IN-AIR-KR/26_HC056/images/readme/launch_video_thumb.jpg

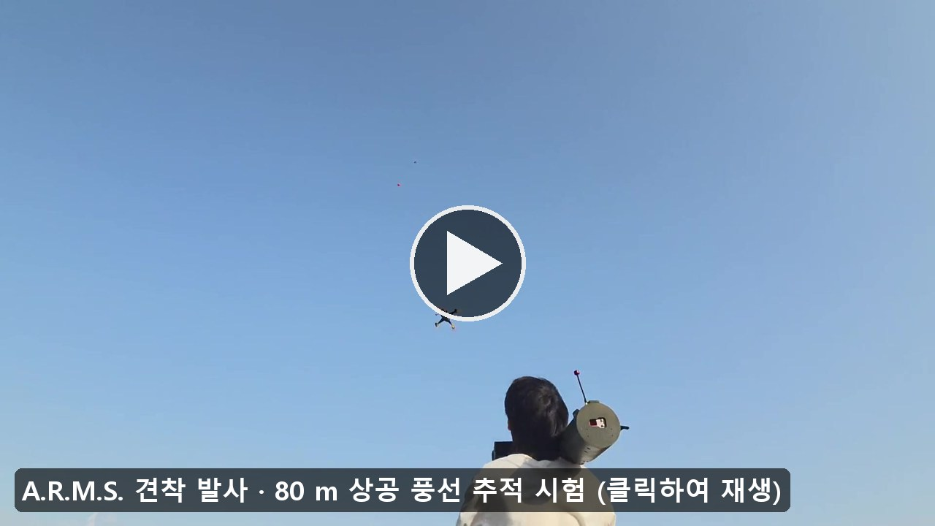
images/readme/launch_video_thumb.jpg
