IN-AIR-KR/26_HC056/SW/arms_ws/src/arms_sim/assets/models/arms_drone/meshes/ver_ksh_assembly.stl

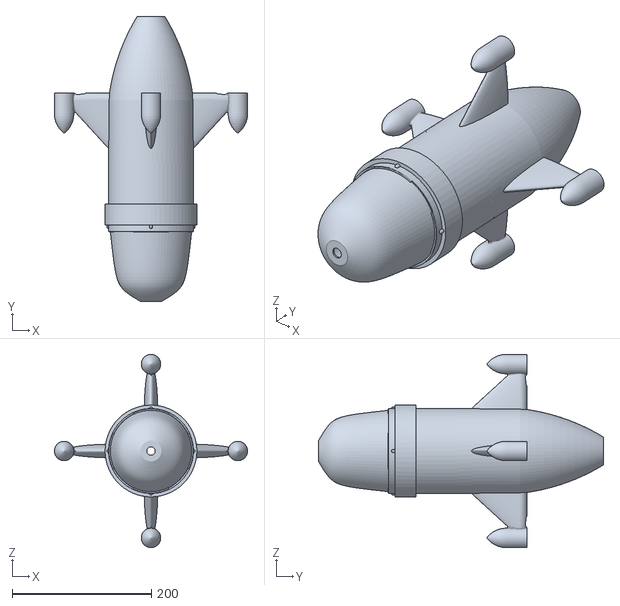
[picture p16: CAD file, 2026-06-16]
SW/arms_ws/src/arms_sim/assets/models/arms_drone/meshes/ver_ksh_assembly.stl
278.0 x 410.0 x 278.0
