IN-AIR-KR/26_HC056/HW/drone_step/electronics_mount_3.step

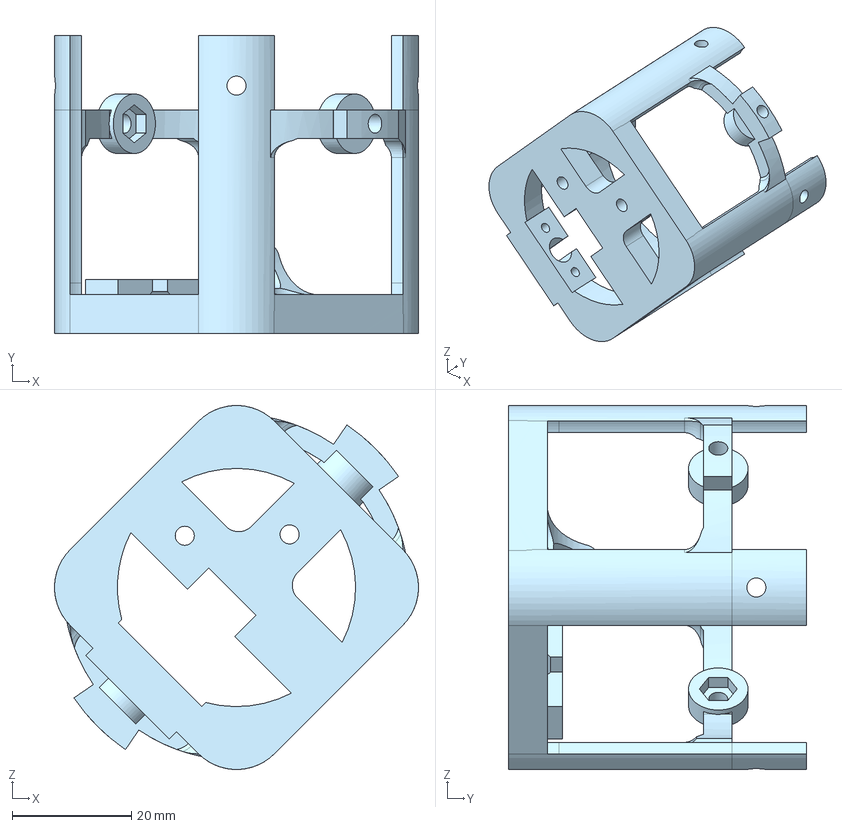
[picture p17: CAD file, 2026-10-19]
HW/drone_step/electronics_mount_3.step
61.1 x 50.0 x 61.1 mm
