IN-AIR-KR/26_HC056/HW/launcher_step/control_panel.step

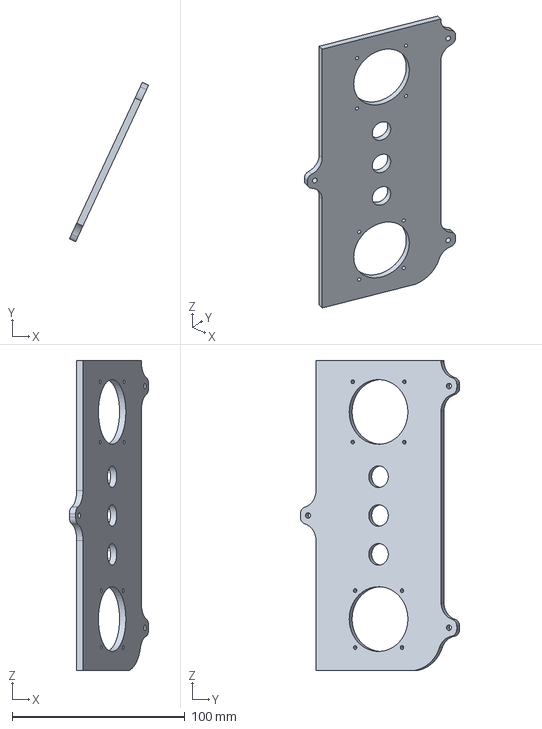
[picture p18: CAD file, 2026-10-19]
HW/launcher_step/control_panel.step
45.9 x 92.3 x 179.6 mm
