IN-AIR-KR/26_HC056/SW/arms_ws/src/arms_sim/assets/models/arms_drone/meshes/arms_model_v2.stl

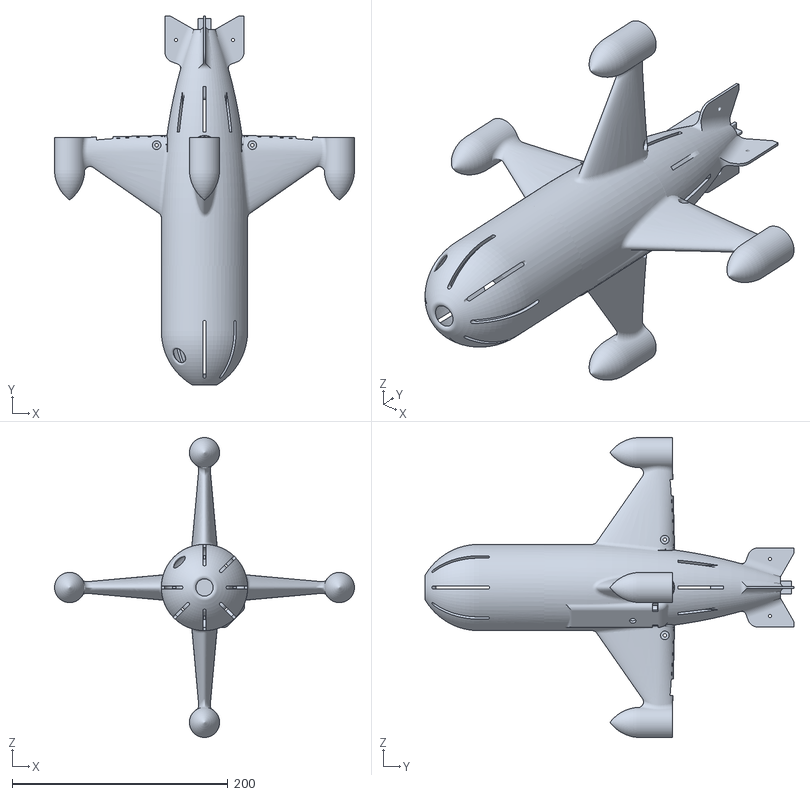
[picture p19: CAD file, 2026-08-10]
SW/arms_ws/src/arms_sim/assets/models/arms_drone/meshes/arms_model_v2.stl
278.0 x 341.9 x 278.0
