IN-AIR-KR/26_HC056/HW/drone_step/electronics_mount_1.step

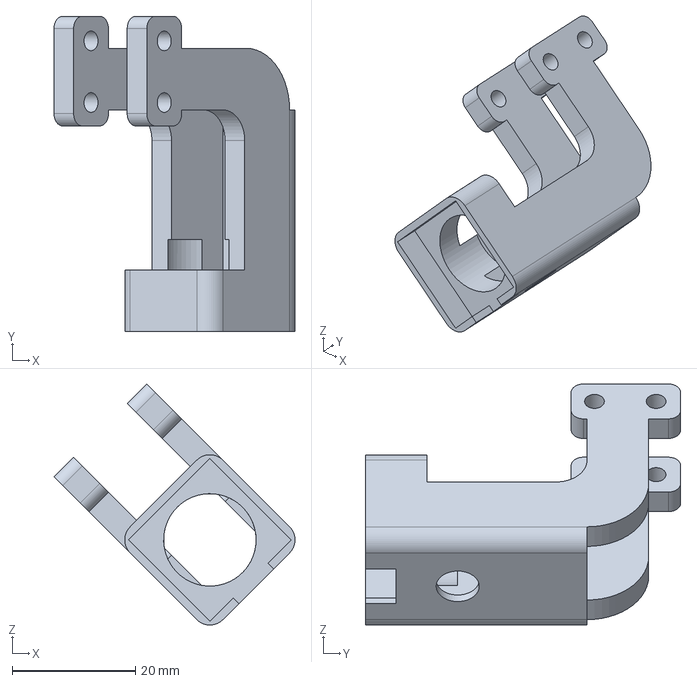
[picture p20: CAD file, 2026-10-19]
HW/drone_step/electronics_mount_1.step
39.1 x 51.2 x 39.1 mm
