IN-AIR-KR/26_HC056/HW/launcher_step/head.step

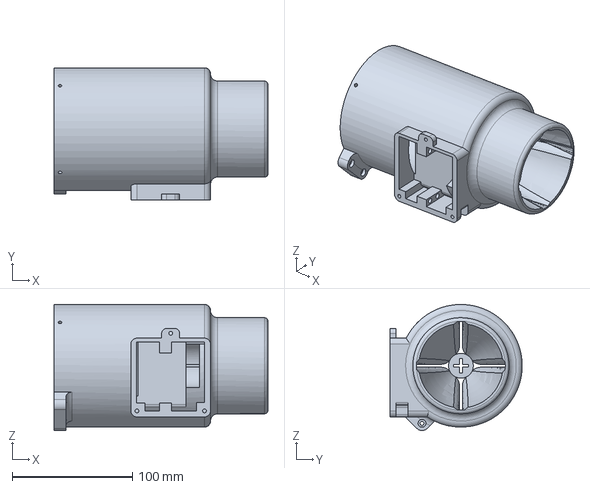
[picture p21: CAD file, 2026-10-19]
HW/launcher_step/head.step
178.0 x 110.1 x 104.9 mm
