IN-AIR-KR/26_HC056/SW/arms_ws/src/arms_sim/assets/models/arms_drone/meshes/1345_prop_cw.stl

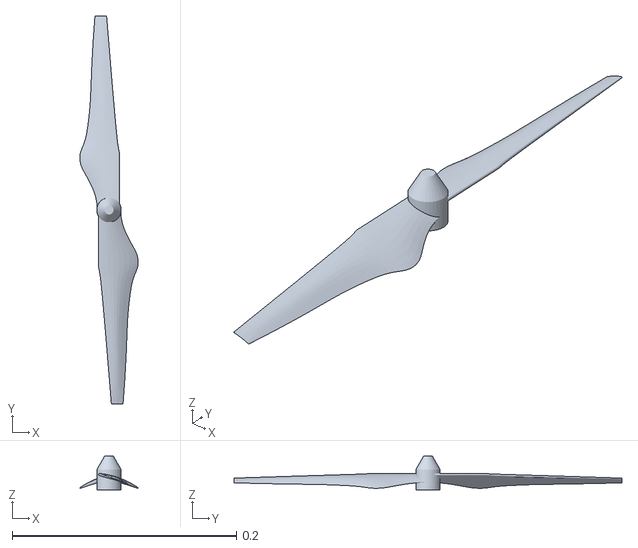
[picture p22: CAD file, 2026-06-16]
SW/arms_ws/src/arms_sim/assets/models/arms_drone/meshes/1345_prop_cw.stl
0.052 x 0.346 x 0.03
