IN-AIR-KR/26_HC056/HW/drone_step/body_1.step

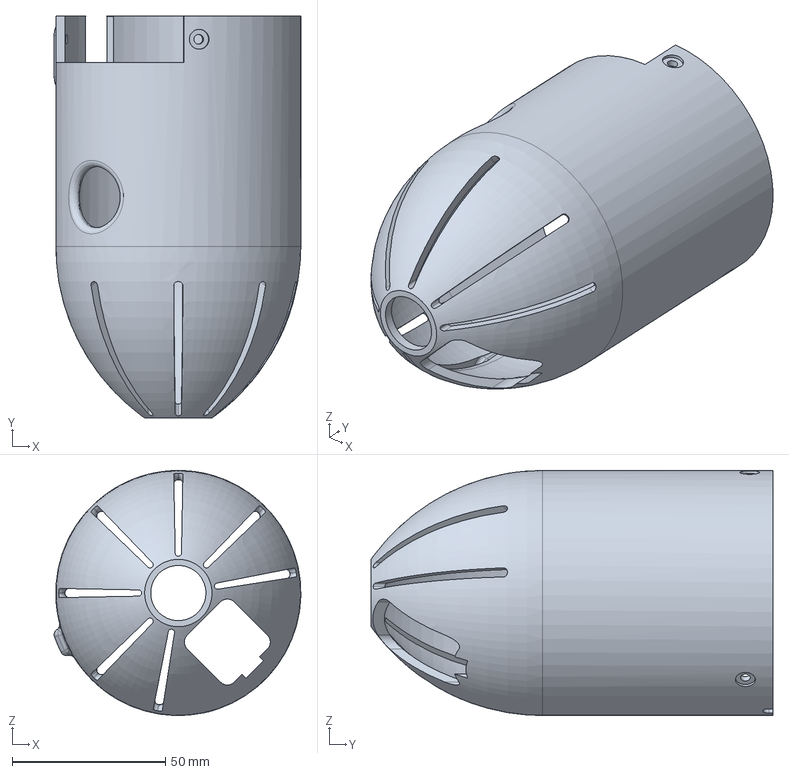
[picture p23: CAD file, 2026-10-19]
HW/drone_step/body_1.step
80.5 x 131.2 x 80.0 mm
