IN-AIR-KR/26_HC056/HW/launcher_step/servo_cover.step

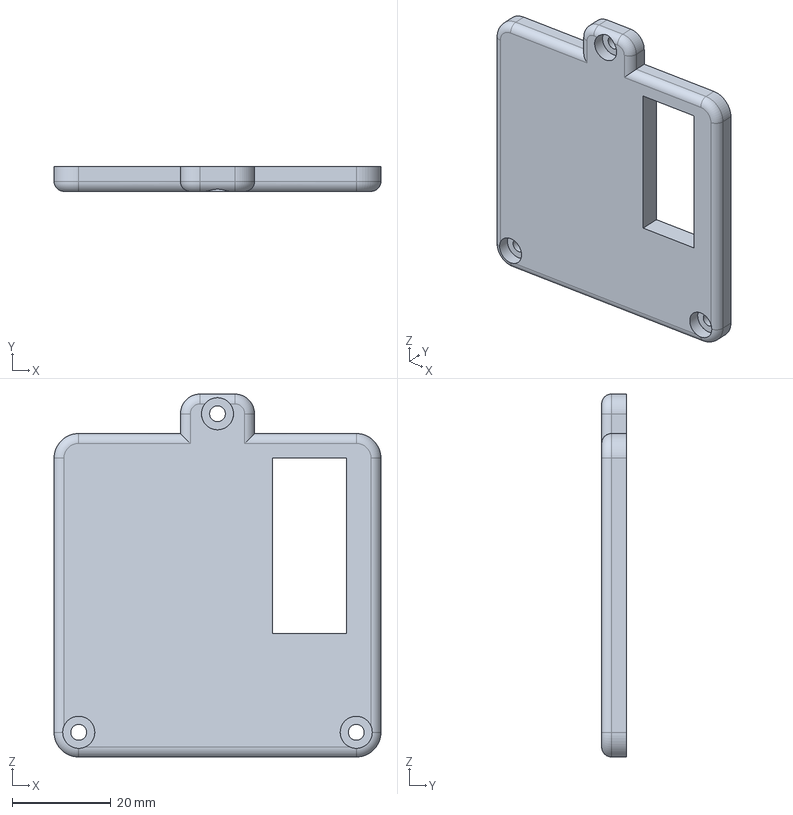
[picture p24: CAD file, 2026-10-19]
HW/launcher_step/servo_cover.step
66.2 x 5.00 x 73.5 mm
