IN-AIR-KR/26_HC056/HW/drone_step/electronics_mount_4.step

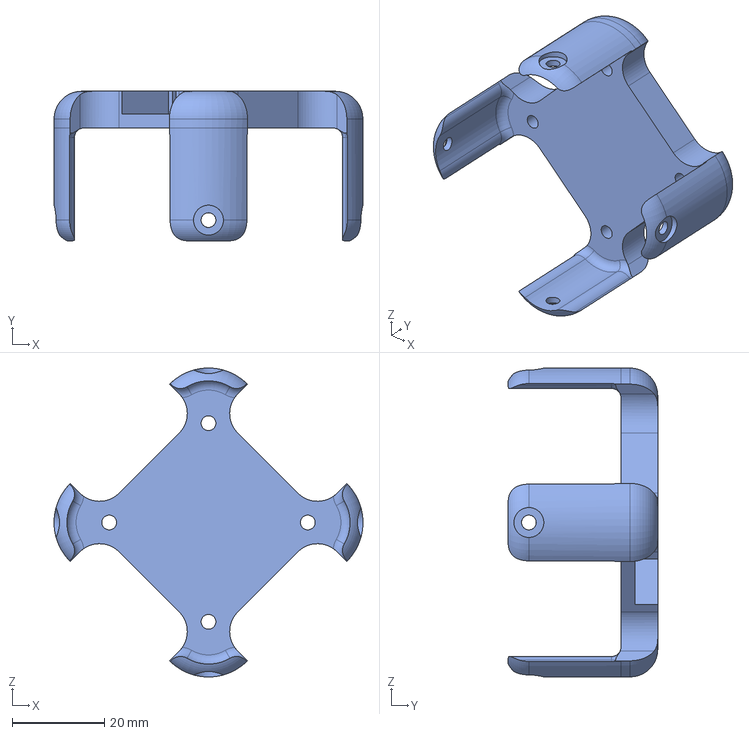
[picture p25: CAD file, 2026-10-19]
HW/drone_step/electronics_mount_4.step
67.1 x 32.5 x 67.1 mm
