IN-AIR-KR/26_HC056/HW/launcher_step/body.step

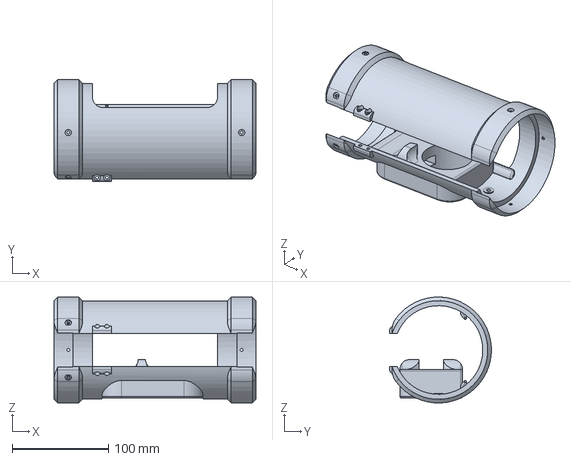
[picture p26: CAD file, 2026-10-19]
HW/launcher_step/body.step
209.6 x 105.7 x 110.0 mm
