IN-AIR-KR/26_HC056/HW/drone_step/body_2.step

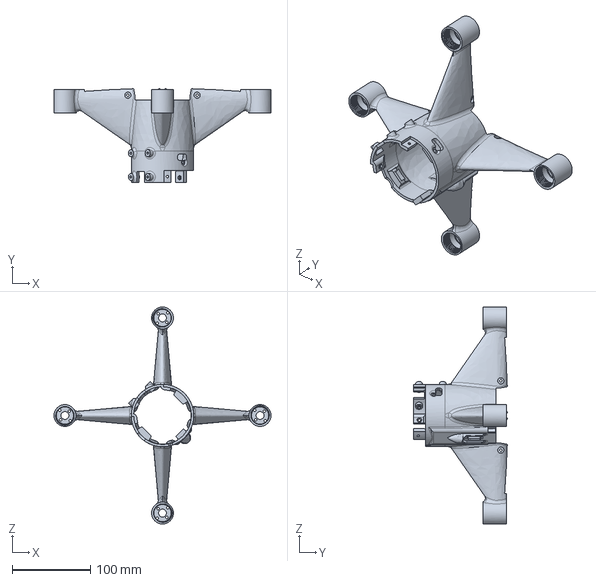
[picture p27: CAD file, 2026-10-19]
HW/drone_step/body_2.step
278.0 x 120.6 x 278.0 mm
