IN-AIR-KR/26_HC056/HW/launcher_step/second_body.step

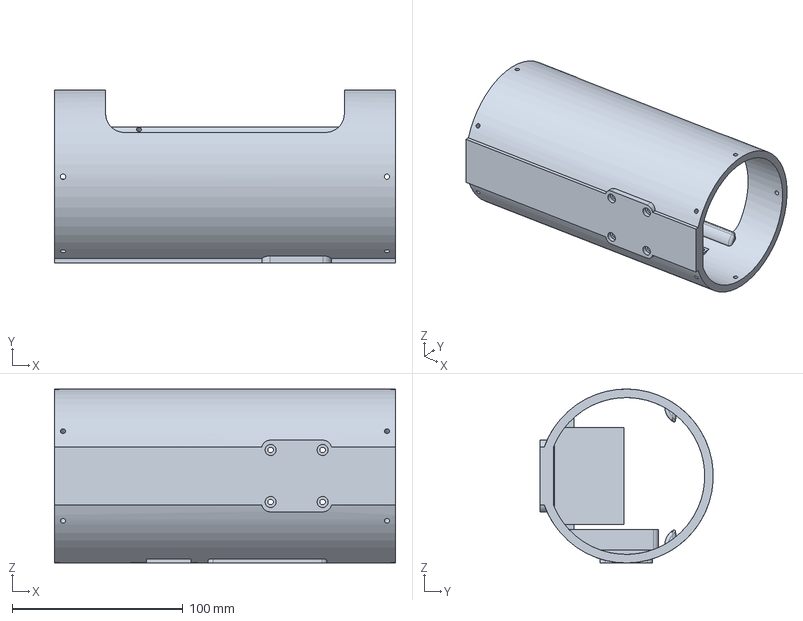
[picture p28: CAD file, 2026-10-19]
HW/launcher_step/second_body.step
200.0 x 101.7 x 102.0 mm
