IN-AIR-KR/26_HC056/HW/drone_step/electronics_mount_2.step

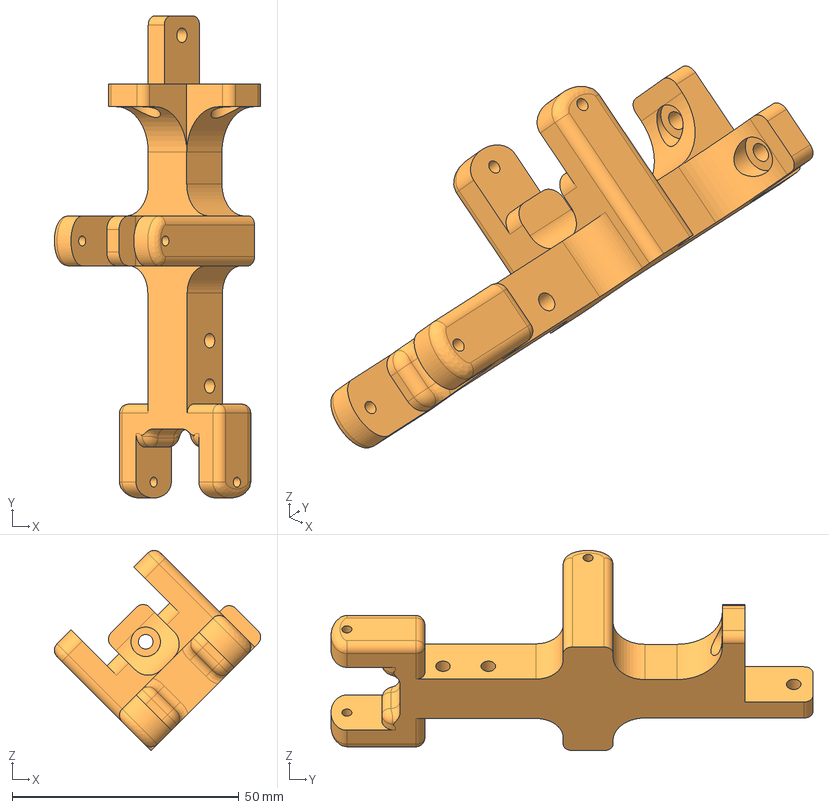
[picture p29: CAD file, 2026-10-19]
HW/drone_step/electronics_mount_2.step
45.5 x 106.3 x 44.1 mm
