IN-AIR-KR/26_HC056/HW/launcher_step/trigger.step

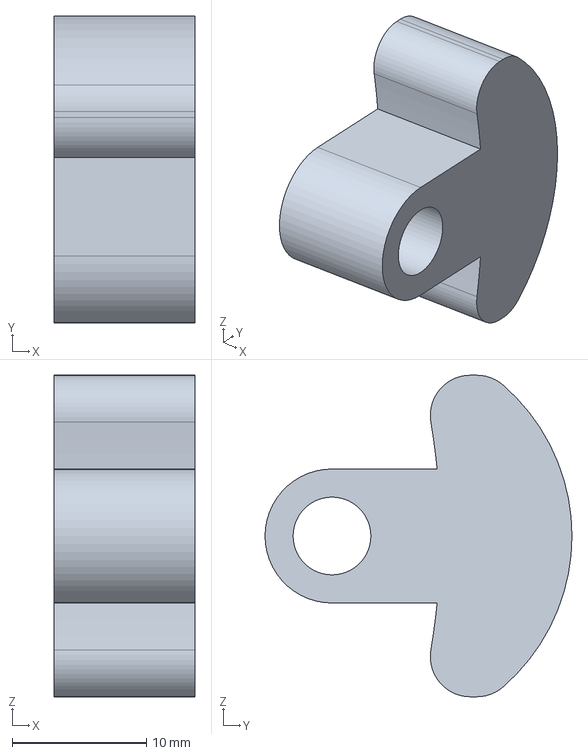
[picture p30: CAD file, 2026-10-19]
HW/launcher_step/trigger.step
10.5 x 22.9 x 24.0 mm
