IN-AIR-KR/26_HC056/HW/drone_step/body_3.step

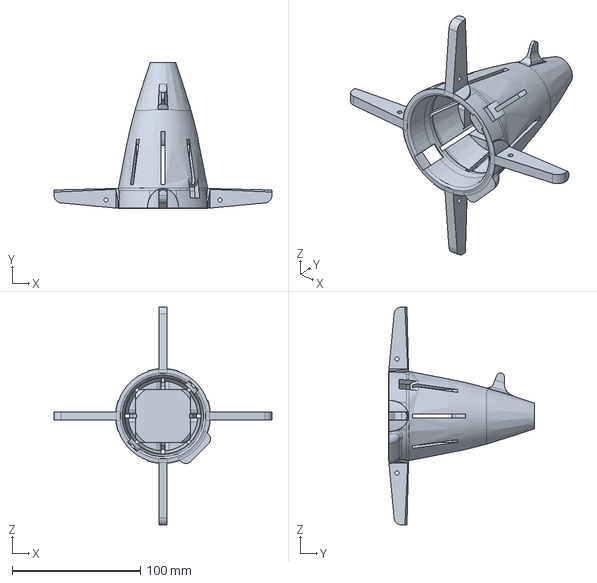
[picture p31: CAD file, 2026-10-19]
HW/drone_step/body_3.step
170.0 x 113.9 x 170.0 mm
