IN-AIR-KR/26_HC056/HW/launcher_step/grip_cover.step

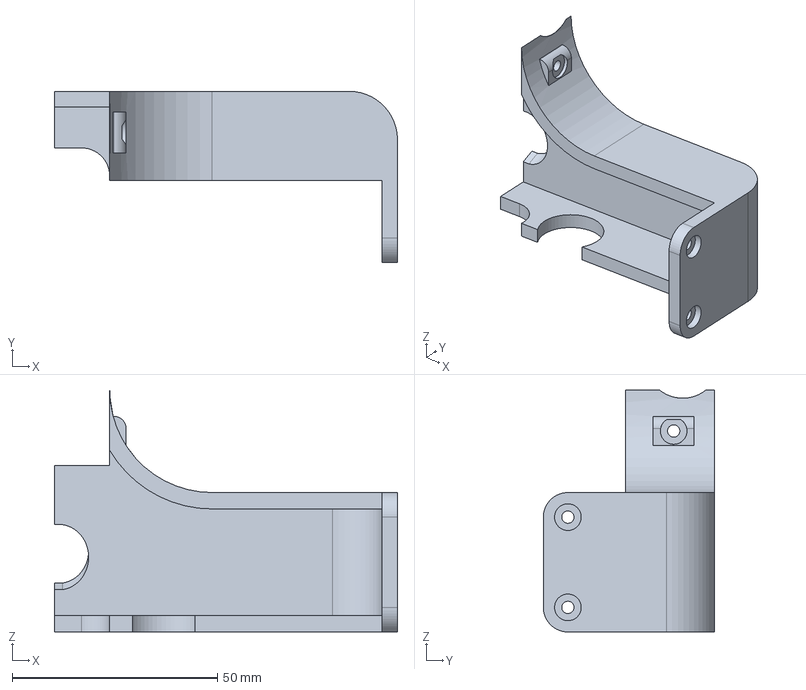
[picture p32: CAD file, 2026-10-19]
HW/launcher_step/grip_cover.step
83.6 x 41.8 x 59.0 mm
