IN-AIR-KR/26_HC056/HW/launcher_step/display_bracket.step

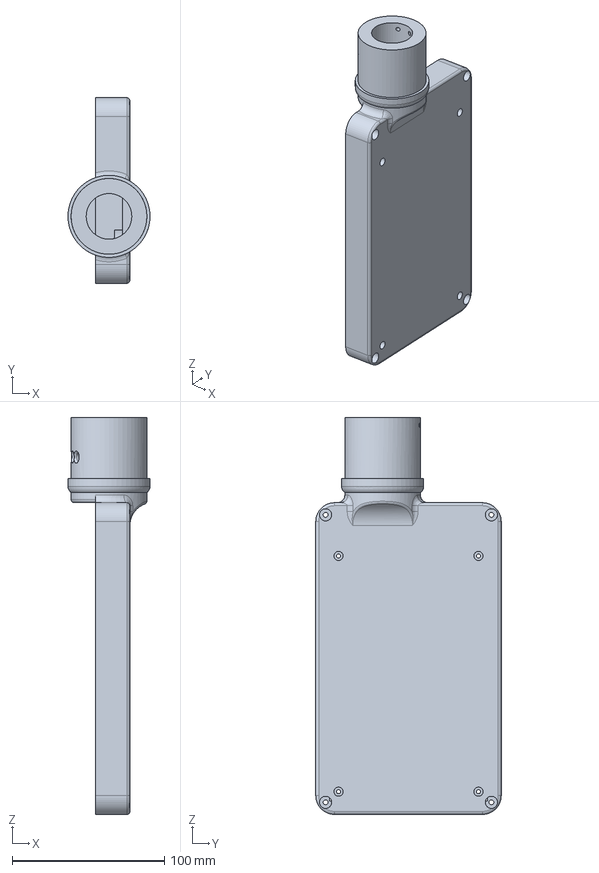
[picture p33: CAD file, 2026-10-19]
HW/launcher_step/display_bracket.step
54.0 x 122.0 x 261.0 mm
