IN-AIR-KR/26_HC056/HW/launcher_step/display_bracket_ring.step

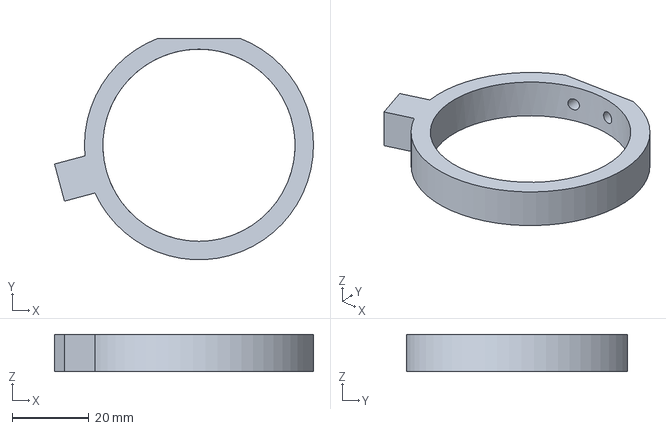
[picture p34: CAD file, 2026-10-19]
HW/launcher_step/display_bracket_ring.step
67.4 x 57.6 x 9.70 mm
