IN-AIR-KR/26_HC056/HW/launcher_step/grip.step

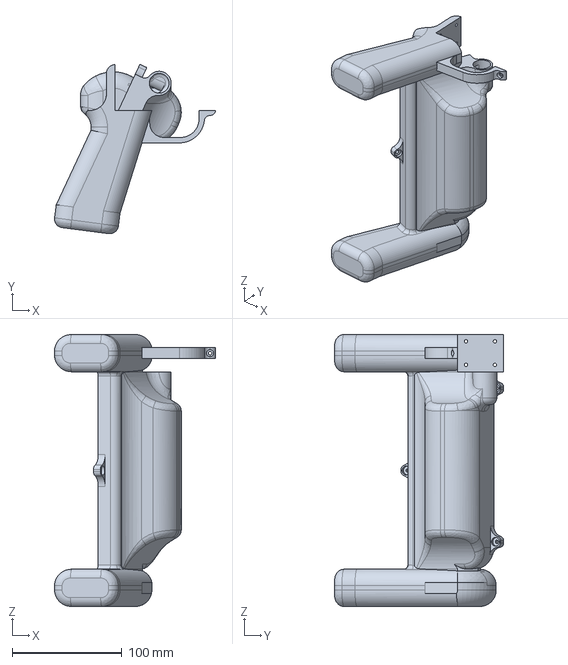
[picture p35: CAD file, 2026-10-19]
HW/launcher_step/grip.step
146.8 x 154.5 x 248.0 mm
