IN-AIR-KR/26_HC056/HW/launcher_step/display_sunshade.step

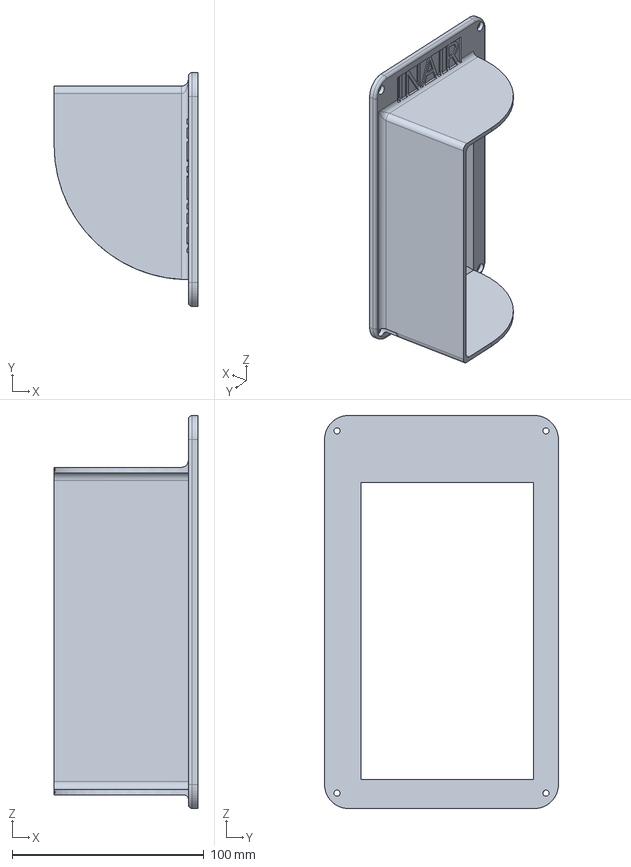
[picture p36: CAD file, 2026-10-19]
HW/launcher_step/display_sunshade.step
75.0 x 122.0 x 205.0 mm
