IN-AIR-KR/26_HC056/HW/launcher_step/second_body_lid.step

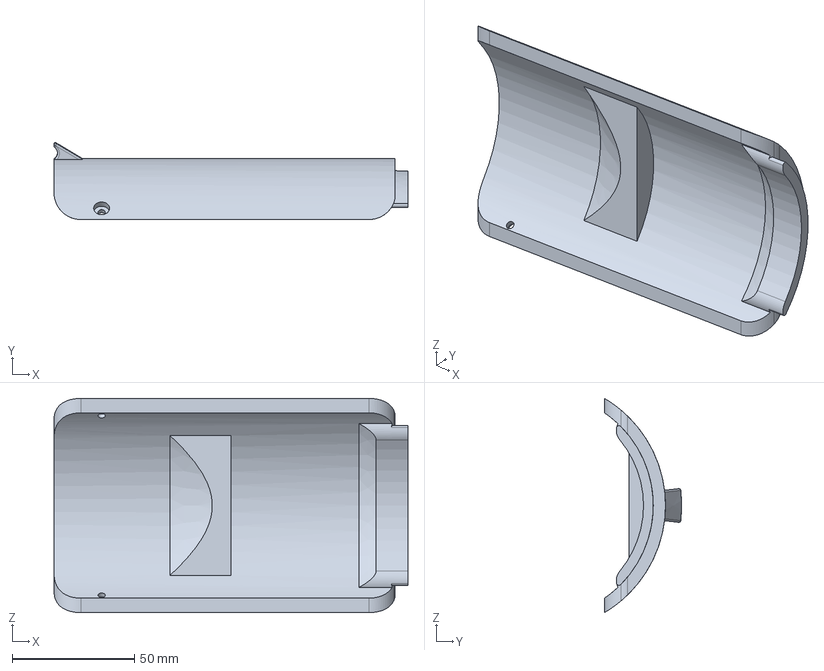
[picture p37: CAD file, 2026-10-19]
HW/launcher_step/second_body_lid.step
145.0 x 31.6 x 87.7 mm
