IN-AIR-KR/26_HC056/HW/launcher_step/body_display_mount.step

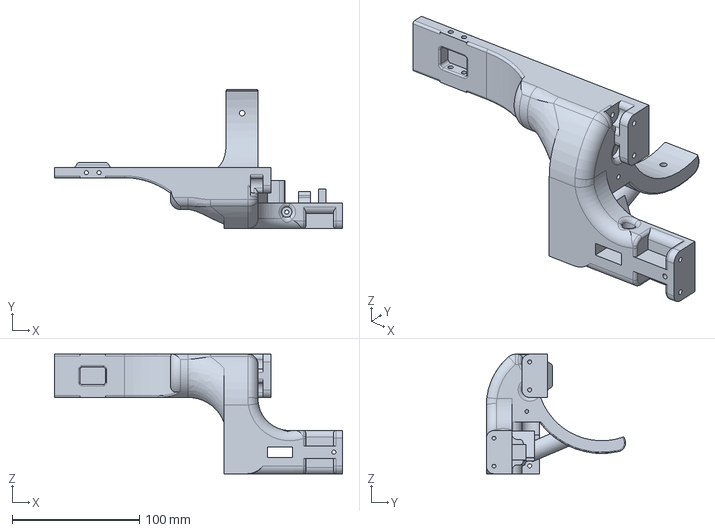
[picture p38: CAD file, 2026-10-19]
HW/launcher_step/body_display_mount.step
226.4 x 109.5 x 94.0 mm
