IN-AIR-KR/26_HC056/HW/launcher_step/tail_bottom.step

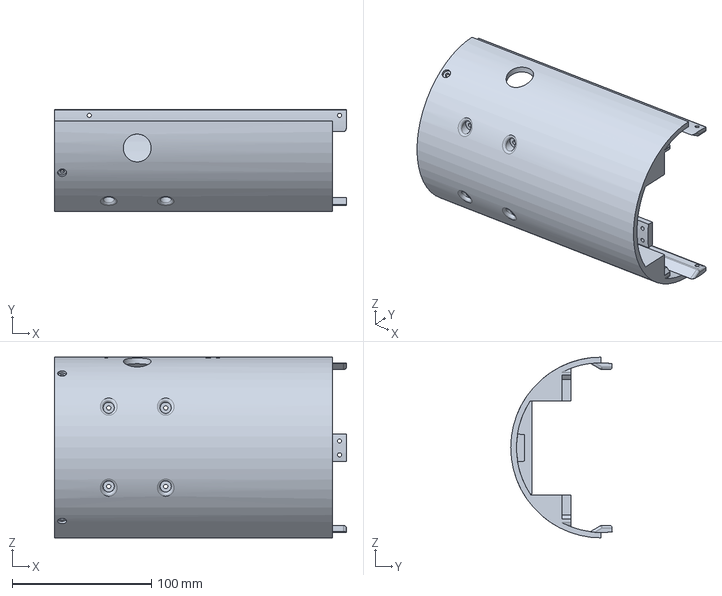
[picture p39: CAD file, 2026-10-19]
HW/launcher_step/tail_bottom.step
210.0 x 73.0 x 130.0 mm
