IN-AIR-KR/26_HC056/HW/launcher_step/tail_latch_cover.step

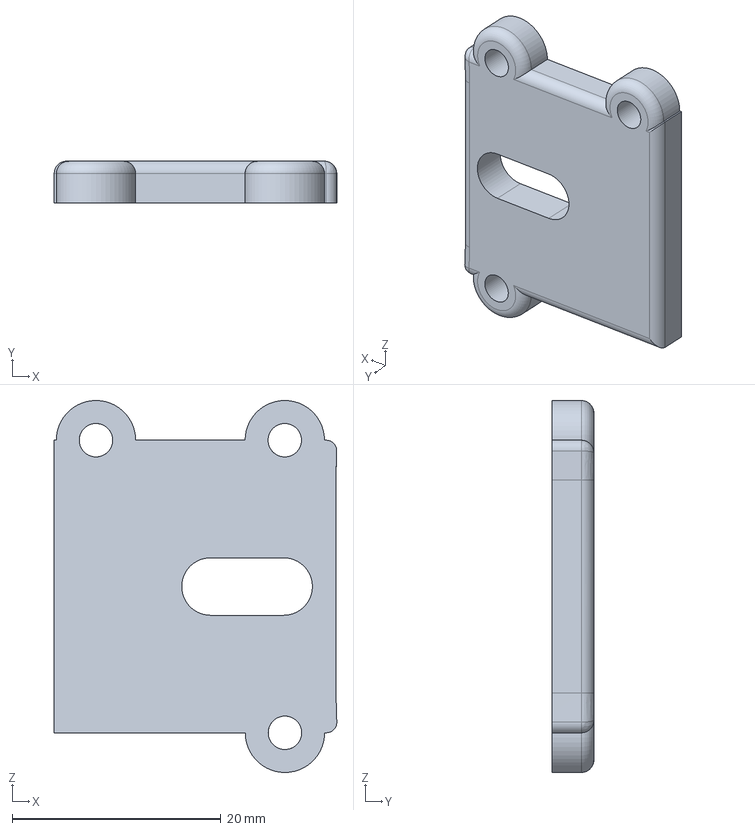
[picture p40: CAD file, 2026-10-19]
HW/launcher_step/tail_latch_cover.step
27.0 x 4.00 x 35.6 mm
