IN-AIR-KR/26_HC056/HW/launcher_step/third_body_lid.step

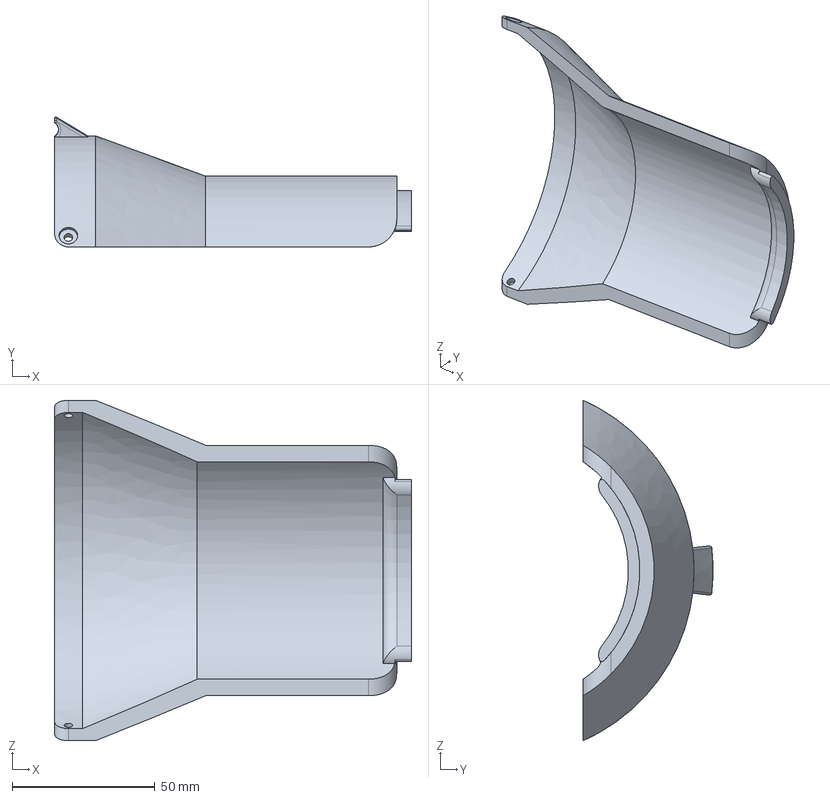
[picture p41: CAD file, 2026-10-19]
HW/launcher_step/third_body_lid.step
124.8 x 45.4 x 119.0 mm
