IN-AIR-KR/26_HC056/HW/launcher_step/body_lid.step

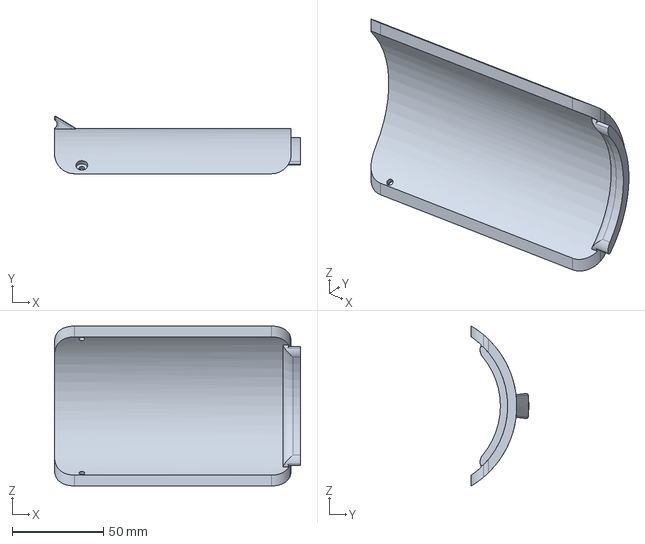
[picture p43: CAD file, 2026-10-19]
HW/launcher_step/body_lid.step
135.0 x 31.6 x 87.7 mm
