IN-AIR-KR/26_HC056/HW/launcher_step/trigger_pusher.step

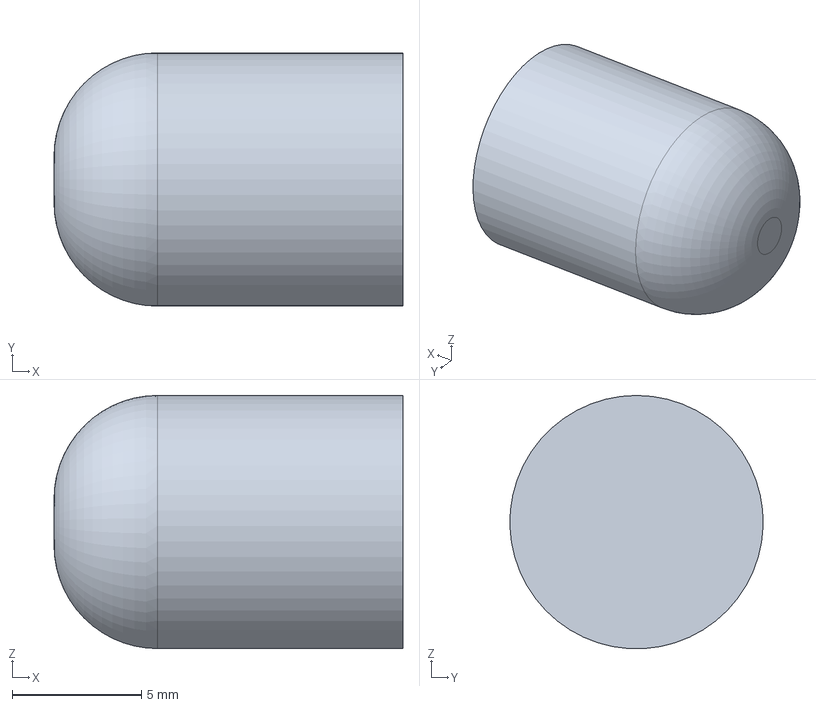
[picture p44: CAD file, 2026-10-19]
HW/launcher_step/trigger_pusher.step
13.5 x 9.80 x 9.79 mm
