IN-AIR-KR/26_HC056/HW/launcher_step/tail_top.step

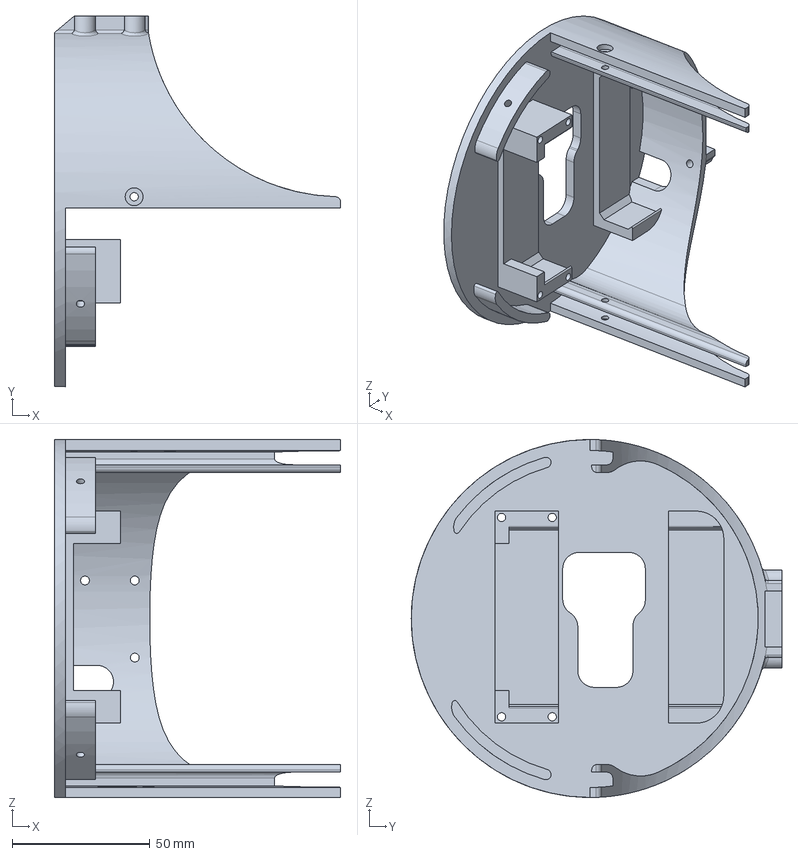
[picture p45: CAD file, 2026-10-19]
HW/launcher_step/tail_top.step
104.0 x 134.5 x 130.0 mm
