IN-AIR-KR/26_HC056/HW/launcher_step/orin_nano_case_top.step

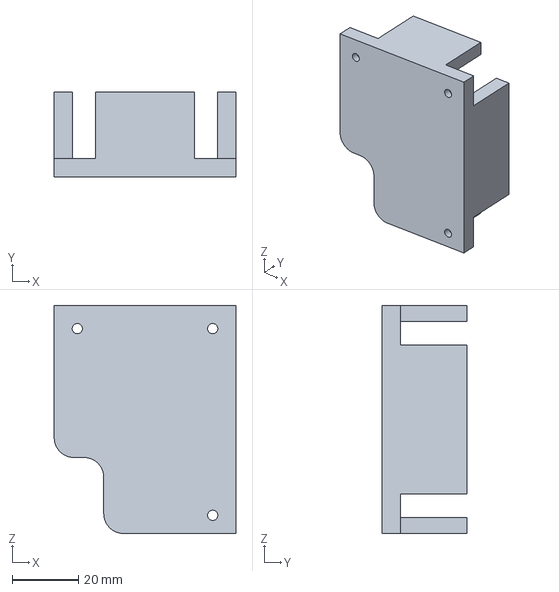
[picture p46: CAD file, 2026-10-19]
HW/launcher_step/orin_nano_case_top.step
55.0 x 25.6 x 69.0 mm
