IN-AIR-KR/26_HC056/HW/launcher_step/third_body.step

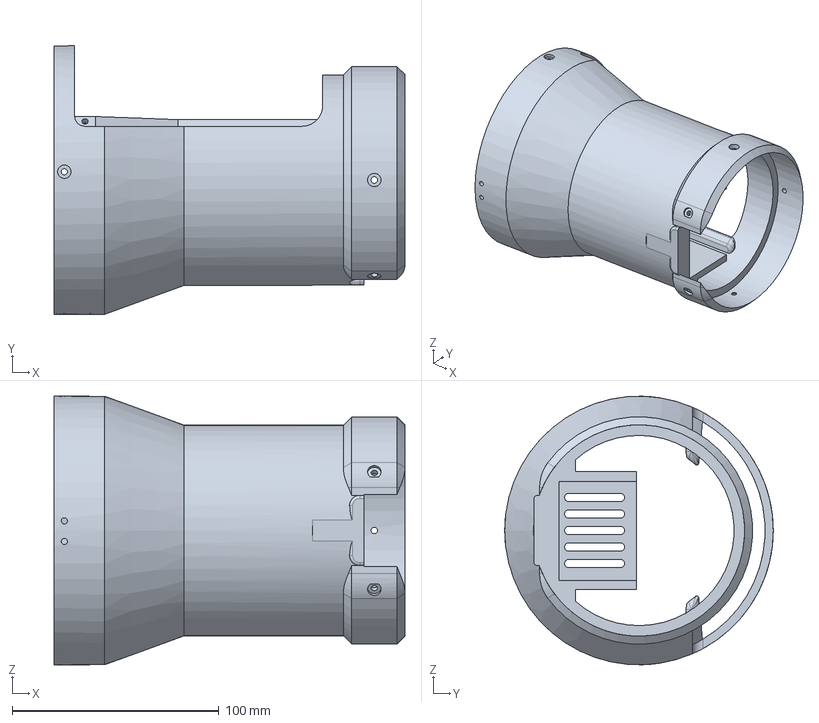
[picture p47: CAD file, 2026-10-19]
HW/launcher_step/third_body.step
169.8 x 130.0 x 130.0 mm
