IN-AIR-KR/26_HC056/HW/launcher_step/tail_top_1.step

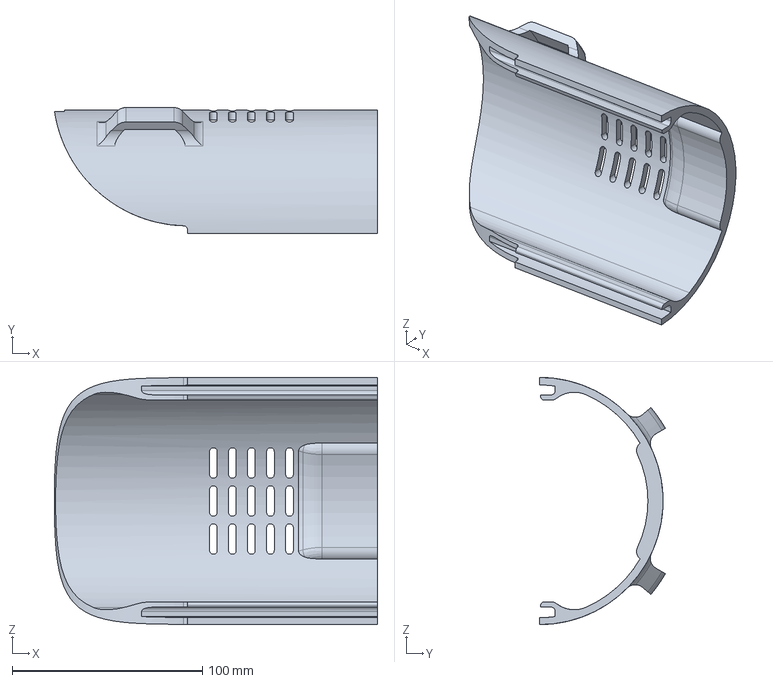
[picture p48: CAD file, 2026-10-19]
HW/launcher_step/tail_top_1.step
169.9 x 66.2 x 130.0 mm
