IN-AIR-KR/26_HC056/HW/launcher_step/orin_nano_case_1.step

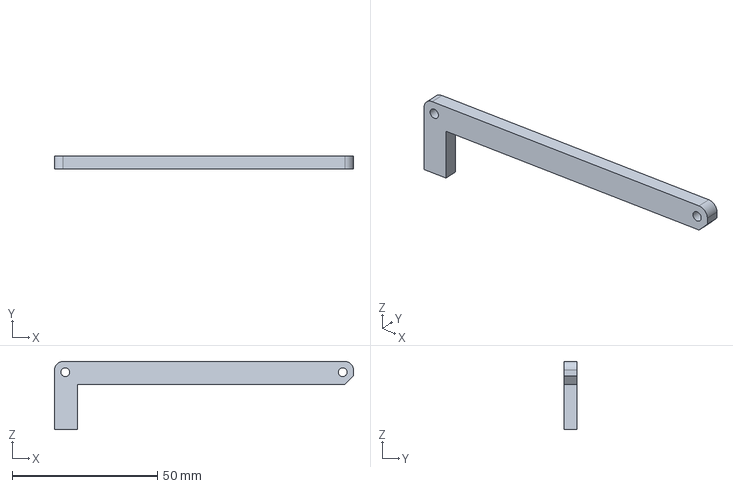
[picture p49: CAD file, 2026-10-19]
HW/launcher_step/orin_nano_case_1.step
103.0 x 4.50 x 23.5 mm
