IN-AIR-KR/26_HC056/(list of files, cad)

Other CAD files:
SW/arms_ws/src/arms_sim/assets/models/arms_drone/meshes/1345_prop_ccw.stl
HW/drone_step/motor_screw_mount.step
