IN-AIR-KR/26_HC056/HW/drone_step/README.md

# Drone STEP

A.R.M.S. 요격 기체의 3D CAD 파일(STEP)입니다. Gazebo 시뮬레이션용 모델은 `../drone/`에 따로 있습니다.

| 파일 | 부품 |
|---|---|
| `body_1.step` | 본체 1 |
| `body_2.step` | 본체 2 |
| `body_3.step` | 본체 3 |
| `electronics_mount_1.step` | 전장 마운트 1 (기체 내부 전장 고정부) |
| `electronics_mount_2.step` | 전장 마운트 2 |
| `electronics_mount_3.step` | 전장 마운트 3 |
| `electronics_mount_4.step` | 전장 마운트 4 |
| `motor_screw_mount.step` | 모터 나사 체결부 |
