IN-AIR-KR/26_HC056/HW/launcher_step/README.md

# Launcher STEP

A.R.M.S. 견착형 발사기의 3D CAD 파일(STEP)입니다.

| 파일 | 부품 |
|---|---|
| `body.step` | 본체 1 |
| `body_lid.step` | 본체 1 덮개 |
| `second_body.step` | 본체 2 |
| `second_body_lid.step` | 본체 2 덮개 |
| `third_body.step` | 본체 3 |
| `third_body_lid.step` | 본체 3 덮개 |
| `head.step` | 헤드 |
| `tail_top.step` | 테일 상부 |
| `tail_top_1.step` | 테일 상부 (변형) |
| `tail_bottom.step` | 테일 하부 |
| `tail_latch_cover.step` | 테일 누름식 개폐부 덮개 |
| `display_bracket.step` | 디스플레이 고정대 (본체 연결) |
| `display_sunshade.step` | 디스플레이 차양막 |
| `body_display_mount.step` | 본체-디스플레이 연결부 |
| `display_bracket_ring.step` | 디스플레이 브라켓-본체 연결부에 끼우는 링 |
| `grip.step` | 손잡이 |
| `grip_cover.step` | 손잡이 덮개 |
| `control_panel.step` | 조작 패널 |
| `trigger.step` | 방아쇠 |
| `trigger_pusher.step` | 방아쇠를 당기면 밀려나 발사 버튼을 눌러주는 연동 부품 |
| `servo_cover.step` | 서보모터 덮개 |
| `orin_nano_case_1.step` | Jetson Orin Nano 케이스 1 |
| `orin_nano_case_2.step` | Jetson Orin Nano 케이스 2 |
| `orin_nano_case_top.step` | Jetson Orin Nano 케이스 상판 |
