IN-AIR-KR/26_HC056/SW/arms_ws/src/arms_sim/assets/models/arms_drone/model.sdf

<?xml version="1.0"?>
<!--
  arms_drone — 자체 완결형 ARMS 드론 모델 (Gazebo Harmonic, SDF 1.9)

  x500 구조를 인라인하고, 동체 메시를 ARMS 커스텀 STL로 교체.
  PX4 모델 디렉토리에 arms_drone 심볼릭 링크만 걸면 작동.

  구성:
    - base_link       : 동체(커스텀 STL) + 센서(IMU/mag/baro/GPS) + collision
    - rotor 0~3       : 프로펠러 + 모터벨 + MulticopterMotorModel 플러그인
    - upward_camera   : 위쪽 카메라 센서 (720x480 RGB, 실기체 FPV 해상도)

  Gazebo 토픽:
    /arms_drone/upward_camera/image   (gz.msgs.Image)
-->
<sdf version="1.9">
  <model name="arms_drone">
    <pose>0 0 0.24 0 0 0</pose>
    <self_collide>false</self_collide>
    <static>false</static>

    <!-- ================================================================
         base_link — 동체 + 센서
         ================================================================ -->
    <link name="base_link">
      <!-- 요격드론 물리량: AUW = 1.04kg (동체 1.008 + 로터 4×0.008).
           관성은 이전값을 질량비로 스케일한 근사 — 실기체 실측 관성으로 교체하면
           rate PID 튜닝 전이가 더 정확해진다. -->
      <inertial>
        <mass>1.008</mass>
        <!-- 카메라는 base_link sensor라 질량이 없다. base와 rotor 모두 모터 축 높이에
             질량 중심을 두어 전체 CoM을 z=-0.087m로 맞춘다. -->
        <pose>0 0 -0.087 0 0 0</pose>
        <inertia>
          <ixx>0.0019</ixx>
          <ixy>0</ixy>
          <ixz>0</ixz>
          <iyy>0.0019</iyy>
          <iyz>0</iyz>
          <izz>0.0033</izz>
        </inertia>
      </inertial>
      <gravity>true</gravity>
      <velocity_decay/>

      <!-- ARMS 커스텀 동체 (arms_model_v2.stl, 동체+암+모터포드, 스핀 프로펠러는 별도 링크).
           STL은 mm 실치수(278×342×278mm) → scale 0.001. Y-up(Fusion)→ -90°(X)로 Z-up,
           yaw +45°(0.7854)로 X-쿼드 대각 정렬 → 모터포드가 정확히 (±0.0976,±0.0976)에 옴. -->
      <visual name="base_link_visual">
        <pose>0 0 0 -1.5708 0 0.7854</pose>
        <geometry>
          <mesh>
            <scale>0.001 0.001 0.001</scale>
            <uri>model://arms_drone/meshes/arms_model_v2.stl</uri>
          </mesh>
        </geometry>
        <!-- 무광 블랙 -->
        <material>
          <ambient>0.02 0.02 0.02 1</ambient>
          <diffuse>0.05 0.05 0.05 1</diffuse>
          <specular>0.12 0.12 0.12 1</specular>
        </material>
      </visual>

      <!-- Collision — 로켓형 요격드론 실루엣 반영 (2박스).
           하부: 꼬리(-0.191)~중단(-0.01), 폭0.11 → 꼬리 착지 + 안정 베이스.
           상부: 노즈/동체(-0.01~+0.15), 폭0.08 → 표적 요격(위쪽 충돌) 판정.
           하부 박스 바닥 = 비주얼 최하단 = 지면 → 클리핑 없음. -->
      <collision name="base_link_collision_0">
        <pose>0 0 -0.1005 0 0 0</pose>
        <geometry>
          <box><size>0.11 0.11 0.181</size></box>
        </geometry>
        <surface>
          <contact><ode><min_depth>0.001</min_depth><max_vel>0</max_vel></ode></contact>
          <friction><ode/></friction>
        </surface>
      </collision>
      <collision name="base_link_collision_1">
        <pose>0 0 0.07 0 0 0</pose>
        <geometry>
          <box><size>0.08 0.08 0.16</size></box>
        </geometry>
        <surface>
          <contact><ode><min_depth>0.001</min_depth><max_vel>0</max_vel></ode></contact>
          <friction><ode/></friction>
        </surface>
      </collision>

      <!-- Sensors -->
      <sensor name="air_pressure_sensor" type="air_pressure">
        <gz_frame_id>base_link</gz_frame_id>
        <always_on>1</always_on>
        <update_rate>50</update_rate>
        <air_pressure>
          <pressure><noise type="gaussian"><mean>0</mean><stddev>3</stddev></noise></pressure>
        </air_pressure>
      </sensor>

      <sensor name="magnetometer_sensor" type="magnetometer">
        <gz_frame_id>base_link</gz_frame_id>
        <always_on>1</always_on>
        <update_rate>100</update_rate>
        <magnetometer>
          <x><noise type="gaussian"><stddev>0.0001</stddev></noise></x>
          <y><noise type="gaussian"><stddev>0.0001</stddev></noise></y>
          <z><noise type="gaussian"><stddev>0.0001</stddev></noise></z>
        </magnetometer>
      </sensor>

      <sensor name="imu_sensor" type="imu">
        <gz_frame_id>base_link</gz_frame_id>
        <always_on>1</always_on>
        <update_rate>250</update_rate>
        <imu>
          <angular_velocity>
            <x><noise type="gaussian"><mean>0.0</mean><stddev>0.0008726646</stddev></noise></x>
            <y><noise type="gaussian"><mean>0.0</mean><stddev>0.0008726646</stddev></noise></y>
            <z><noise type="gaussian"><mean>0.0</mean><stddev>0.0008726646</stddev></noise></z>
          </angular_velocity>
          <linear_acceleration>
            <x><noise type="gaussian"><mean>0.0</mean><stddev>0.00637</stddev></noise></x>
            <y><noise type="gaussian"><mean>0.0</mean><stddev>0.00637</stddev></noise></y>
            <z><noise type="gaussian"><mean>0.0</mean><stddev>0.00686</stddev></noise></z>
          </linear_acceleration>
        </imu>
      </sensor>

      <sensor name="navsat_sensor" type="navsat">
        <gz_frame_id>base_link</gz_frame_id>
        <always_on>1</always_on>
        <update_rate>30</update_rate>
      </sensor>

      <!-- Upward-facing camera: massless sensor, optical axis = body +Z. -->
      <sensor name="upward_camera" type="camera">
        <pose>0 0 0.15 0 -1.5708 0</pose>
        <always_on>true</always_on>
        <update_rate>60</update_rate>
        <camera>
          <!-- RunCam Phoenix 2 SE V2 (1/2" CMOS, 6.4x4.8mm) + 8mm lens:
               hfov = 2*atan(3.2/8) = 0.7610 rad = 43.6 deg. -->
          <horizontal_fov>0.7610</horizontal_fov>
          <image>
            <width>720</width>
            <height>480</height>
            <format>R8G8B8</format>
          </image>
          <clip>
            <near>0.1</near>
            <far>100</far>
          </clip>
        </camera>
        <topic>/arms_drone/upward_camera/image</topic>
      </sensor>
    </link>

    <!-- ================================================================
         Rotors (4x)
         ================================================================ -->

    <!-- Rotor 0 — front-right, CCW -->
    <link name="rotor_0">
      <gravity>true</gravity>
      <self_collide>false</self_collide>
      <velocity_decay/>
      <pose>0.0876 -0.0876 -0.087 0 0 0</pose>
      <inertial>
        <mass>0.008</mass>
        <inertia>
          <ixx>2.0e-07</ixx>
          <iyy>1.3e-05</iyy>
          <izz>1.3e-05</izz>
        </inertia>
      </inertial>
      <visual name="rotor_0_visual">
        <pose>-0.00944 0.0628 0.00686 3.14159 0 0</pose>   <!-- 프로펠러 상하반전(roll 180°)+센터링. 회전 반영해 오프셋 재계산(안하면 다시 밀림). 추력은 플러그인이 조인트축으로 내므로 영향無 -->
        <geometry>
          <mesh>
            <scale>0.363 0.363 0.363</scale>
            <uri>model://arms_drone/meshes/1345_prop_ccw.stl</uri>
          </mesh>
        </geometry>
        <material><script><name>Gazebo/DarkGrey</name><uri>file://media/materials/scripts/gazebo.material</uri></script></material>
      </visual>
      <!-- 모터벨 제거: arms_model_v2.stl 동체가 모터포드를 이미 포함 -->
      <collision name="rotor_0_collision">
        <pose>0 0 0 0 0 0</pose>
        <geometry><box><size>0.11 0.012 0.001</size></box></geometry>
        <surface><contact><ode><min_depth>0.001</min_depth><max_vel>0</max_vel></ode></contact><friction><ode/></friction></surface>
      </collision>
    </link>
    <joint name="rotor_0_joint" type="revolute">
      <parent>base_link</parent><child>rotor_0</child>
      <axis><xyz>0 0 1</xyz><limit><lower>-1e+16</lower><upper>1e+16</upper></limit><dynamics><spring_reference>0</spring_reference><spring_stiffness>0</spring_stiffness></dynamics></axis>
    </joint>

    <!-- Rotor 1 — rear-left, CCW -->
    <link name="rotor_1">
      <gravity>true</gravity>
      <self_collide>false</self_collide>
      <velocity_decay/>
      <pose>-0.0876 0.0876 -0.087 0 0 0</pose>
      <inertial>
        <mass>0.008</mass>
        <inertia>
          <ixx>2.0e-07</ixx>
          <iyy>1.3e-05</iyy>
          <izz>1.3e-05</izz>
        </inertia>
      </inertial>
      <visual name="rotor_1_visual">
        <pose>-0.00944 0.0628 0.00686 3.14159 0 0</pose>   <!-- 프로펠러 상하반전(roll 180°)+센터링. 회전 반영해 오프셋 재계산(안하면 다시 밀림). 추력은 플러그인이 조인트축으로 내므로 영향無 -->
        <geometry>
          <mesh>
            <scale>0.363 0.363 0.363</scale>
            <uri>model://arms_drone/meshes/1345_prop_ccw.stl</uri>
          </mesh>
        </geometry>
        <material><script><name>Gazebo/DarkGrey</name><uri>file://media/materials/scripts/gazebo.material</uri></script></material>
      </visual>
      <collision name="rotor_1_collision">
        <pose>0 0 0 0 0 0</pose>
        <geometry><box><size>0.11 0.012 0.001</size></box></geometry>
        <surface><contact><ode><min_depth>0.001</min_depth><max_vel>0</max_vel></ode></contact><friction><ode/></friction></surface>
      </collision>
    </link>
    <joint name="rotor_1_joint" type="revolute">
      <parent>base_link</parent><child>rotor_1</child>
      <axis><xyz>0 0 1</xyz><limit><lower>-1e+16</lower><upper>1e+16</upper></limit><dynamics><spring_reference>0</spring_reference><spring_stiffness>0</spring_stiffness></dynamics></axis>
    </joint>

    <!-- Rotor 2 — front-left, CW -->
    <link name="rotor_2">
      <gravity>true</gravity>
      <self_collide>false</self_collide>
      <velocity_decay/>
      <pose>0.0876 0.0876 -0.087 0 0 0</pose>
      <inertial>
        <mass>0.008</mass>
        <inertia>
          <ixx>2.0e-07</ixx>
          <iyy>1.3e-05</iyy>
          <izz>1.3e-05</izz>
        </inertia>
      </inertial>
      <visual name="rotor_2_visual">
        <pose>-0.00944 0.0628 0.00686 3.14159 0 0</pose>   <!-- 프로펠러 상하반전(roll 180°)+센터링. 회전 반영해 오프셋 재계산(안하면 다시 밀림). 추력은 플러그인이 조인트축으로 내므로 영향無 -->
        <geometry>
          <mesh>
            <scale>0.363 0.363 0.363</scale>
            <uri>model://arms_drone/meshes/1345_prop_cw.stl</uri>
          </mesh>
        </geometry>
        <material><script><name>Gazebo/DarkGrey</name><uri>file://media/materials/scripts/gazebo.material</uri></script></material>
      </visual>
      <collision name="rotor_2_collision">
        <pose>0 0 0 0 0 0</pose>
        <geometry><box><size>0.11 0.012 0.001</size></box></geometry>
        <surface><contact><ode><min_depth>0.001</min_depth><max_vel>0</max_vel></ode></contact><friction><ode/></friction></surface>
      </collision>
    </link>
    <joint name="rotor_2_joint" type="revolute">
      <parent>base_link</parent><child>rotor_2</child>
      <axis><xyz>0 0 1</xyz><limit><lower>-1e+16</lower><upper>1e+16</upper></limit><dynamics><spring_reference>0</spring_reference><spring_stiffness>0</spring_stiffness></dynamics></axis>
    </joint>

    <!-- Rotor 3 — rear-right, CW -->
    <link name="rotor_3">
      <gravity>true</gravity>
      <self_collide>false</self_collide>
      <velocity_decay/>
      <pose>-0.0876 -0.0876 -0.087 0 0 0</pose>
      <inertial>
        <mass>0.008</mass>
        <inertia>
          <ixx>2.0e-07</ixx>
          <iyy>1.3e-05</iyy>
          <izz>1.3e-05</izz>
        </inertia>
      </inertial>
      <visual name="rotor_3_visual">
        <pose>-0.00944 0.0628 0.00686 3.14159 0 0</pose>   <!-- 프로펠러 상하반전(roll 180°)+센터링. 회전 반영해 오프셋 재계산(안하면 다시 밀림). 추력은 플러그인이 조인트축으로 내므로 영향無 -->
        <geometry>
          <mesh>
            <scale>0.363 0.363 0.363</scale>
            <uri>model://arms_drone/meshes/1345_prop_cw.stl</uri>
          </mesh>
        </geometry>
        <material><script><name>Gazebo/DarkGrey</name><uri>file://media/materials/scripts/gazebo.material</uri></script></material>
      </visual>
      <collision name="rotor_3_collision">
        <pose>0 0 0 0 0 0</pose>
        <geometry><box><size>0.11 0.012 0.001</size></box></geometry>
        <surface><contact><ode><min_depth>0.001</min_depth><max_vel>0</max_vel></ode></contact><friction><ode/></friction></surface>
      </collision>
    </link>
    <joint name="rotor_3_joint" type="revolute">
      <parent>base_link</parent><child>rotor_3</child>
      <axis><xyz>0 0 1</xyz><limit><lower>-1e+16</lower><upper>1e+16</upper></limit><dynamics><spring_reference>0</spring_reference><spring_stiffness>0</spring_stiffness></dynamics></axis>
    </joint>

    <!-- ================================================================
         Motor plugins (from x500)
         추력 = motorConstant · ω²,  ω_max = maxRotVelocity(1000 rad/s)
         motorConstant 1.4715e-05 → 모터당 최대 1.5 kgf (14.7 N), 4개 6.0 kgf, AUW 1.04kg → TWR≈5.77
         PX4 출력 u(0~1) → ω = 150 + 850·u (airframe SIM_GZ_EC_MIN/MAX) → 호버 u≈0.313
         ================================================================ -->
    <plugin filename="gz-sim-multicopter-motor-model-system" name="gz::sim::systems::MulticopterMotorModel">
      <jointName>rotor_0_joint</jointName>
      <linkName>rotor_0</linkName>
      <turningDirection>ccw</turningDirection>
      <timeConstantUp>0.0125</timeConstantUp>
      <timeConstantDown>0.025</timeConstantDown>
      <maxRotVelocity>1000.0</maxRotVelocity>
      <motorConstant>1.4715e-05</motorConstant>
      <momentConstant>0.016</momentConstant>
      <commandSubTopic>command/motor_speed</commandSubTopic>
      <motorNumber>0</motorNumber>
      <rotorDragCoefficient>8.06428e-05</rotorDragCoefficient>
      <rollingMomentCoefficient>1e-06</rollingMomentCoefficient>
      <rotorVelocitySlowdownSim>10</rotorVelocitySlowdownSim>
      <motorType>velocity</motorType>
    </plugin>
    <plugin filename="gz-sim-multicopter-motor-model-system" name="gz::sim::systems::MulticopterMotorModel">
      <jointName>rotor_1_joint</jointName>
      <linkName>rotor_1</linkName>
      <turningDirection>ccw</turningDirection>
      <timeConstantUp>0.0125</timeConstantUp>
      <timeConstantDown>0.025</timeConstantDown>
      <maxRotVelocity>1000.0</maxRotVelocity>
      <motorConstant>1.4715e-05</motorConstant>
      <momentConstant>0.016</momentConstant>
      <commandSubTopic>command/motor_speed</commandSubTopic>
      <motorNumber>1</motorNumber>
      <rotorDragCoefficient>8.06428e-05</rotorDragCoefficient>
      <rollingMomentCoefficient>1e-06</rollingMomentCoefficient>
      <rotorVelocitySlowdownSim>10</rotorVelocitySlowdownSim>
      <motorType>velocity</motorType>
    </plugin>
    <plugin filename="gz-sim-multicopter-motor-model-system" name="gz::sim::systems::MulticopterMotorModel">
      <jointName>rotor_2_joint</jointName>
      <linkName>rotor_2</linkName>
      <turningDirection>cw</turningDirection>
      <timeConstantUp>0.0125</timeConstantUp>
      <timeConstantDown>0.025</timeConstantDown>
      <maxRotVelocity>1000.0</maxRotVelocity>
      <motorConstant>1.4715e-05</motorConstant>
      <momentConstant>0.016</momentConstant>
      <commandSubTopic>command/motor_speed</commandSubTopic>
      <motorNumber>2</motorNumber>
      <rotorDragCoefficient>8.06428e-05</rotorDragCoefficient>
      <rollingMomentCoefficient>1e-06</rollingMomentCoefficient>
      <rotorVelocitySlowdownSim>10</rotorVelocitySlowdownSim>
      <motorType>velocity</motorType>
    </plugin>
    <plugin filename="gz-sim-multicopter-motor-model-system" name="gz::sim::systems::MulticopterMotorModel">
      <jointName>rotor_3_joint</jointName>
      <linkName>rotor_3</linkName>
      <turningDirection>cw</turningDirection>
      <timeConstantUp>0.0125</timeConstantUp>
      <timeConstantDown>0.025</timeConstantDown>
      <maxRotVelocity>1000.0</maxRotVelocity>
      <motorConstant>1.4715e-05</motorConstant>
      <momentConstant>0.016</momentConstant>
      <commandSubTopic>command/motor_speed</commandSubTopic>
      <motorNumber>3</motorNumber>
      <rotorDragCoefficient>8.06428e-05</rotorDragCoefficient>
      <rollingMomentCoefficient>1e-06</rollingMomentCoefficient>
      <rotorVelocitySlowdownSim>10</rotorVelocitySlowdownSim>
      <motorType>velocity</motorType>
    </plugin>

  </model>
</sdf>
