IN-AIR-KR/26_HC056/SW/arms_ws/src/arms_operator/src/arms_operator_hardware_node.cpp

#include <algorithm>
#include <array>
#include <cerrno>
#include <charconv>
#include <chrono>
#include <cstdint>
#include <cstring>
#include <fcntl.h>
#include <functional>
#include <memory>
#include <stdexcept>
#include <string>
#include <string_view>
#include <system_error>
#include <termios.h>
#include <sys/ioctl.h>
#include <unistd.h>
#include <vector>

#include <rclcpp/rclcpp.hpp>
#include <arms_msgs/msg/operator_input.hpp>

namespace arms_operator
{

// ESP32 펌웨어가 보내는 CSV 패킷 필드.
//   throttle: 0..1000,  roll/pitch/yaw: -1000..1000,  버튼: 0/1
//   CTRL,seq,throttle,roll,pitch,yaw,launch,mode,rtl,arm
// control 노드 OperatorInput 규약으로의 변환은 publishInput 에서 수행한다.
struct ControllerPacket
{
  uint32_t seq = 0;
  int throttle = 0;
  int roll = 0;
  int pitch = 0;
  int yaw = 0;
  int launch = 0;
  int mode = 0;
  int rtl = 0;
  int arm = 0;
};

class ArmsOperatorHardwareNode : public rclcpp::Node
{
public:
  void declare_required_parameter(
    const std::string & name, rclcpp::ParameterType type)
  {
    const auto & value = declare_parameter(name, type);
    if (value.get_type() == rclcpp::ParameterType::PARAMETER_NOT_SET) {
      throw std::runtime_error(
        "Required parameter '" + name + "' is missing for " + get_fully_qualified_name());
    }
  }

  ArmsOperatorHardwareNode()
  : Node("arms_operator_hardware_node")
  {
    declare_required_parameter("topic_name", rclcpp::ParameterType::PARAMETER_STRING);
    declare_required_parameter("serial.device", rclcpp::ParameterType::PARAMETER_STRING);
    declare_required_parameter("serial.baud", rclcpp::ParameterType::PARAMETER_INTEGER);
    declare_required_parameter("serial.poll_rate_hz", rclcpp::ParameterType::PARAMETER_DOUBLE);
    declare_required_parameter("serial.max_line_length", rclcpp::ParameterType::PARAMETER_INTEGER);
    topic_name_ = get_parameter("topic_name").as_string();
    serial_device_ = get_parameter("serial.device").as_string();
    serial_baud_ = get_parameter("serial.baud").as_int();
    poll_rate_hz_ = get_parameter("serial.poll_rate_hz").as_double();
    max_line_length_ = get_parameter("serial.max_line_length").as_int();

    if (poll_rate_hz_ <= 0.0) {
      throw std::runtime_error("serial.poll_rate_hz must be greater than 0");
    }
    if (max_line_length_ < 32) {
      throw std::runtime_error("serial.max_line_length must be at least 32");
    }
    input_pub_ = create_publisher<arms_msgs::msg::OperatorInput>(
      topic_name_,
      rclcpp::SensorDataQoS().keep_last(1)
    );

    openSerialPort();

    const auto period = std::chrono::duration<double>(1.0 / poll_rate_hz_);
    poll_timer_ = create_wall_timer(
      std::chrono::duration_cast<std::chrono::nanoseconds>(period),
      std::bind(&ArmsOperatorHardwareNode::pollSerial, this));

    RCLCPP_INFO(
      get_logger(),
      "USB controller node started: device=%s, baud=%d, topic=%s, poll=%.1f Hz",
      serial_device_.c_str(), serial_baud_, topic_name_.c_str(), poll_rate_hz_);
    RCLCPP_INFO(
      get_logger(),
      "Expected packet: CTRL,seq,throttle,roll,pitch,yaw,launch,mode,rtl,arm");
  }

  ~ArmsOperatorHardwareNode() override
  {
    closeSerialPort();
  }

private:
  static speed_t baudToTermios(int baud)
  {
    switch (baud) {
      case 9600:
        return B9600;
      case 19200:
        return B19200;
      case 38400:
        return B38400;
      case 57600:
        return B57600;
      case 115200:
        return B115200;
#ifdef B230400
      case 230400:
        return B230400;
#endif
      default:
        throw std::runtime_error("Unsupported serial baud rate: " + std::to_string(baud));
    }
  }

  void openSerialPort()
  {
    serial_fd_ = ::open(
      serial_device_.c_str(),
      O_RDWR | O_NOCTTY | O_NONBLOCK | O_CLOEXEC);

    if (serial_fd_ < 0) {
      throw std::runtime_error(
              "Failed to open " + serial_device_ + ": " + std::strerror(errno));
    }

    termios tty{};
    if (tcgetattr(serial_fd_, &tty) != 0) {
      const std::string error = std::strerror(errno);
      closeSerialPort();
      throw std::runtime_error("tcgetattr failed: " + error);
    }

    cfmakeraw(&tty);

    const speed_t speed = baudToTermios(serial_baud_);
    cfsetispeed(&tty, speed);
    cfsetospeed(&tty, speed);

    // 8 data bits, no parity, 1 stop bit, no flow control (8N1).
    tty.c_cflag &= ~CSIZE;
    tty.c_cflag |= CS8;
    tty.c_cflag &= ~PARENB;
    tty.c_cflag &= ~CSTOPB;
#ifdef CRTSCTS
    tty.c_cflag &= ~CRTSCTS;
#endif
    tty.c_cflag |= CLOCAL | CREAD;

    // Non-blocking read. The ROS timer performs polling.
    tty.c_cc[VMIN] = 0;
    tty.c_cc[VTIME] = 0;

    if (tcsetattr(serial_fd_, TCSANOW, &tty) != 0) {
      const std::string error = std::strerror(errno);
      closeSerialPort();
      throw std::runtime_error("tcsetattr failed: " + error);
    }

    // ESP32-S3 USB CDC는 호스트가 DTR을 활성화해야 데이터를 내보내는 경우가 있다.
    // RTS는 비활성화하여 불필요한 리셋 신호를 피한다.
    int modem_bits = 0;
    if (::ioctl(serial_fd_, TIOCMGET, &modem_bits) == 0) {
      modem_bits |= TIOCM_DTR;
      modem_bits &= ~TIOCM_RTS;
      if (::ioctl(serial_fd_, TIOCMSET, &modem_bits) != 0) {
        RCLCPP_WARN(
          get_logger(),
          "Failed to set DTR/RTS on %s: %s",
          serial_device_.c_str(), std::strerror(errno));
      }
    } else {
      RCLCPP_WARN(
        get_logger(),
        "Failed to read DTR/RTS state on %s: %s",
        serial_device_.c_str(), std::strerror(errno));
    }

    tcflush(serial_fd_, TCIOFLUSH);
  }

  void closeSerialPort()
  {
    if (serial_fd_ >= 0) {
      ::close(serial_fd_);
      serial_fd_ = -1;
    }
  }

  void pollSerial()
  {
    readAvailableBytes();
    processLatestLine();   // 밀린 백로그는 버리고 최신 패킷만 처리 (제어 지연·이력 재생 방지)
    // 미완성 꼬리가 비정상적으로 커지면(프레이밍 붕괴) 버린다.
    constexpr std::size_t kMaximumRxBuffer = 4096;
    if (rx_buffer_.size() > kMaximumRxBuffer) {
      RCLCPP_WARN_THROTTLE(
        get_logger(), *get_clock(), 1000,
        "USB serial buffer overflow (%zu bytes, no newline) — clearing.",
        rx_buffer_.size());
      rx_buffer_.clear();
    }
  }

  void readAvailableBytes()
  {
    if (serial_fd_ < 0) {
      return;
    }

    std::array<char, 256> buffer{};

    while (true) {
      const ssize_t count = ::read(serial_fd_, buffer.data(), buffer.size());

      if (count > 0) {
        rx_buffer_.append(buffer.data(), static_cast<std::size_t>(count));
        continue;
      }

      if (count == 0) {
        break;
      }

      if (errno == EAGAIN || errno == EWOULDBLOCK) {
        break;
      }

      RCLCPP_ERROR_THROTTLE(
        get_logger(), *get_clock(), 1000,
        "USB serial read failed on %s: %s",
        serial_device_.c_str(), std::strerror(errno));
      break;
    }
    // 버퍼 상한 처리는 processLatestLine 이후(최신 패킷 추출 후) pollSerial 에서 한다.
  }

  // 밀린 백로그(오래된 패킷)는 버리고 가장 최신 완성 패킷 1개만 처리한다.
  //   조종 입력은 "현재 스위치/스틱 위치"만 의미가 있으므로 과거 값을 재생할 필요가 없다.
  //   → 제어 지연 최소화 + 시작 시 누적된 과거 이력 재생(효과음 폭주)·오작동 방지.
  void processLatestLine()
  {
    const std::size_t last_nl = rx_buffer_.rfind('\n');
    if (last_nl == std::string::npos) {
      return;  // 아직 완성된 줄이 없음 → 다음 폴링까지 대기
    }

    // 마지막 '\n' 으로 끝나는(=가장 최신) 줄의 시작 위치를 찾는다.
    std::size_t line_start = 0;
    if (last_nl > 0) {
      const std::size_t prev_nl = rx_buffer_.rfind('\n', last_nl - 1);
      if (prev_nl != std::string::npos) {
        line_start = prev_nl + 1;
      }
    }

    std::string line = rx_buffer_.substr(line_start, last_nl - line_start);
    // 최신 줄 + 그 앞의 모든 백로그를 버리고, 미완성 꼬리만 남긴다.
    rx_buffer_.erase(0, last_nl + 1);

    if (!line.empty() && line.back() == '\r') {
      line.pop_back();
    }
    if (line.empty()) {
      return;
    }
    if (line.size() > static_cast<std::size_t>(max_line_length_)) {
      RCLCPP_WARN_THROTTLE(
        get_logger(), *get_clock(), 1000,
        "Discarding overlong USB serial line (%zu bytes)", line.size());
      return;
    }

    ControllerPacket packet;
    std::string parse_error;
    if (!parsePacket(line, packet, parse_error)) {
      RCLCPP_WARN_THROTTLE(
        get_logger(), *get_clock(), 1000,
        "Discarding invalid USB serial packet: %s; line='%s'",
        parse_error.c_str(), line.c_str());
      return;
    }

    handleValidPacket(packet);
  }

  static std::vector<std::string_view> splitCsv(const std::string & line)
  {
    std::vector<std::string_view> fields;
    std::size_t begin = 0;

    while (true) {
      const std::size_t comma = line.find(',', begin);
      if (comma == std::string::npos) {
        fields.emplace_back(line.data() + begin, line.size() - begin);
        break;
      }

      fields.emplace_back(line.data() + begin, comma - begin);
      begin = comma + 1;
    }

    return fields;
  }

  template<typename IntegerT>
  static bool parseInteger(std::string_view text, IntegerT & value)
  {
    if (text.empty()) {
      return false;
    }

    const char * first = text.data();
    const char * last = text.data() + text.size();
    const auto result = std::from_chars(first, last, value);
    return result.ec == std::errc{} && result.ptr == last;
  }

  static bool inRange(int value, int minimum, int maximum)
  {
    return value >= minimum && value <= maximum;
  }

  static bool parsePacket(
    const std::string & line,
    ControllerPacket & packet,
    std::string & error)
  {
    const auto fields = splitCsv(line);

    // CTRL + 9 data fields = 10 CSV fields.
    if (fields.size() != 10) {
      error = "expected 10 CSV fields, got " + std::to_string(fields.size());
      return false;
    }

    if (fields[0] != "CTRL") {
      error = "packet prefix is not CTRL";
      return false;
    }

    if (!parseInteger(fields[1], packet.seq) ||
      !parseInteger(fields[2], packet.throttle) ||
      !parseInteger(fields[3], packet.roll) ||
      !parseInteger(fields[4], packet.pitch) ||
      !parseInteger(fields[5], packet.yaw) ||
      !parseInteger(fields[6], packet.launch) ||
      !parseInteger(fields[7], packet.mode) ||
      !parseInteger(fields[8], packet.rtl) ||
      !parseInteger(fields[9], packet.arm))
    {
      error = "one or more fields are not valid integers";
      return false;
    }

    if (!inRange(packet.throttle, 0, 1000)) {
      error = "throttle is outside 0..1000";
      return false;
    }
    if (!inRange(packet.roll, -1000, 1000) ||
      !inRange(packet.pitch, -1000, 1000) ||
      !inRange(packet.yaw, -1000, 1000))
    {
      error = "roll, pitch, or yaw is outside -1000..1000";
      return false;
    }
    if (!inRange(packet.launch, 0, 1) ||
      !inRange(packet.mode, 0, 1) ||
      !inRange(packet.rtl, 0, 1) ||
      !inRange(packet.arm, 0, 1))
    {
      error = "launch, mode, rtl, and arm must be 0 or 1";
      return false;
    }

    return true;
  }

  void handleValidPacket(const ControllerPacket & packet)
  {
    publishInput(packet);
  }

  void publishInput(const ControllerPacket & packet)
  {
    arms_msgs::msg::OperatorInput msg;
    msg.header.stamp = now();
    msg.roll = static_cast<float>(packet.roll) / 1000.0F;
    msg.pitch = static_cast<float>(packet.pitch) / 1000.0F;
    msg.throttle = static_cast<float>(packet.throttle) / 500.0F - 1.0F;
    msg.yaw = static_cast<float>(packet.yaw) / 1000.0F;
    msg.arm_switch = static_cast<bool>(packet.arm);
    msg.manual_mode = static_cast<bool>(packet.mode);
    msg.launch_request = static_cast<bool>(packet.launch);
    msg.rtl_switch = static_cast<bool>(packet.rtl);
    // I/O 경계에서는 유효 패킷을 그대로 전달한다. 입력 단절·RTL 같은 안전
    // 판단은 control 노드가 마지막 수신 시각을 기준으로 수행한다.
    msg.input_lost = false;
    input_pub_->publish(msg);
  }

  std::string topic_name_;
  std::string serial_device_;
  int serial_baud_ = 115200;
  double poll_rate_hz_ = 200.0;
  int max_line_length_ = 128;

  int serial_fd_ = -1;
  std::string rx_buffer_;

  rclcpp::Publisher<arms_msgs::msg::OperatorInput>::SharedPtr input_pub_;
  rclcpp::TimerBase::SharedPtr poll_timer_;
};

}  // namespace arms_operator

int main(int argc, char ** argv)
{
  rclcpp::init(argc, argv);

  try {
    rclcpp::spin(std::make_shared<arms_operator::ArmsOperatorHardwareNode>());
  } catch (const std::exception & error) {
    RCLCPP_FATAL(rclcpp::get_logger("arms_operator_hardware"), "%s", error.what());
    rclcpp::shutdown();
    return 1;
  }

  rclcpp::shutdown();
  return 0;
}
