IN-AIR-KR/26_HC056/(commit log)

2026-05-08 add jetson gpio code
    [display_monitor.step]
2026-05-08 upload main1 project
    [display_monitor.step]
2026-05-08 feat: baseline code (test required)
    [arms_sitl.sdf, model.sdf]
2026-05-08 chore: clearup folder
    [display_monitor.step]
2026-05-10 fix: video node가 실기체, SITL 모두에서 작동하게
2026-05-10 fix: docker를 local 버전과 jetson 버전을 분리
2026-05-10 docs: 문서 최신화 및 TODO 추가
2026-05-14 fix: upward_cam model
    [model.sdf]
2026-05-14 fix: change arams_drones color format
    [model.sdf]
2026-05-14 fix: add sensor
    [arms_sitl.sdf]
2026-05-14 fix: camera error
    [model.sdf]
2026-05-14 Fix: MAVSDK ComponentType 버전 호환 수정, MAVLink 포트 14540으로 변경
    [control_params.yaml]
2026-05-15 fix: arms_ui 안 뜨는 오류 수정
    [arms_sitl.sdf]
2026-05-16 fix: 실기체에서도 offboard 스트림 안정화 이후 즉시 arm
    [arms_control_node.cpp]
2026-05-16 fix: detection node 해상도 이슈 수정
2026-05-16 fix: mavlink connection url 수정
    [control_params.yaml]
2026-05-16 docs: git lfs, docker 실행, opencv_sitl 실행 내용 추가
2026-05-16 feat: yolo 테스트 및 tensorRT 변환 코드 추가
2026-06-16 control: 시간기반 P 램프로 교체, 최대각 90, 직선 풍선모드 삭제
    [arms_sitl.sdf, model.sdf]
2026-06-16 sim: 드론모델(x500/x500_base 커스텀)+airframe vendoring, setup_sim.sh, run_arms 경로독립화
    [1345_prop_ccw.stl, 1345_prop_cw.stl, model.sdf, ver_ksh_assembly.stl]
2026-06-16 detect: 3개 독립토글(hsv/yolo/absdiff) 다중선택 / 시작P 60 / 풍선 50m / 심볼릭 자동 / README
2026-06-26 sim: arms_sitl world에 gravity/magnetic_field 추가
    magnetic_field 누락으로 PX4가 compass uncalibrated / no heading 에러를 내며 arm 거부하던 문제 수정.
    [arms_sitl.sdf]
2026-06-26 fix: add spherical_coordinates
    [arms_sitl.sdf]
2026-06-26 fix: simpler model structure
    [arms_sitl.sdf, model.sdf, ver_ksh_assembly.stl]
2026-06-26 fix: only arms_drone
    [1345_prop_ccw.stl, 1345_prop_cw.stl, model.sdf]
2026-06-30 젯슨으로 짐볼이랑 스위치값 받아서 ros2로 출력
    [controller_input_params.yaml]
2026-07-02 fix: px4 위치 달라도 실행되게
2026-07-03 fix: docker ipc도 공유
2026-07-03 fix: yolo docker 데이터 전달 오류 해결
2026-07-07 feat: target as drone
    [arms_sitl.sdf]
2026-07-07 control: err 기반 P 자동조절(err_sched) 추가 + 성공 레시피 yaml 영구저장
    - err_sched: |err| 크기(hypot)에 따라 P 자동 감쇠로 발산 방지
    (enable/full_err/big_err/min_ratio 파라미터)
    - 성공 레시피 yaml 반영: kp_start 33, kp_max 130, ki 0.8, kd 0.6,
    output_limit 95, track_throttle 0.82
    - TRACK 디버그 로그에 errx 비율 표시
    - 개발 로그 문서(DEVELOPMENT_LOG.md) 추가
2026-07-07 요격 제어 개선: 정렬 게이트, pitch 게인 강화, 패널 실시간 튜닝
    - 정렬 게이트: 상승 전 공 중앙 정렬 후 요격
    - pitch 게인 배수 추가 (전진 강화)
    - 패널에 pitch 배수 슬라이더 추가 (실시간 튜닝)
    - 라이다 거리 기반 상승 제어
    - 공 크기 확대, 라이다 콘 조정
    - 하강 로직 제거로 이륙 안정화
    [arms_sitl.sdf, model.sdf]
2026-07-07 요격 제어 개선: 정렬 게이트, pitch 게인 강화, 패널 실시간 튜닝
2026-07-07 fix: fix merge error
    [arms_sitl.sdf]
2026-07-07 fix: fix bracket error
2026-07-07 absdiff 수정
2026-07-07 fix: control, comm 분리
    [arms_control_node.cpp, control_params.yaml, state_machine.cpp]
2026-07-07 refac: arms_commnad를 gpio 입력과 합치기
    [controller_input_params.yaml]
2026-07-07 fix: pymavlink connection error 수정
2026-07-07 fix: arms_command
    [controller_input_params.yaml]
2026-07-07 fix: arm error
2026-07-07 Revert "fix: arm error"
    This reverts commit 867bee2a74eecc44337d6a44bb68b6fee94e5f9c.
2026-07-07 fix: fix model
    [model.sdf]
2026-07-07 fix: sim_setup 변경
2026-07-07 fix: mode 변환 오류 수정
2026-07-08 fix: control, comm 합치기
2026-07-08 fix: arm 타이밍 변경
    [arms_control_node.cpp]
2026-07-08 fix: panel에서 가상 조종기 별도 창으로
2026-07-08 fix: SITL arm 거부 문제 — GCS 없는 standalone 비행 failsafe 비활성화
    NAV_DLL_ACT=2(데이터링크 소실→RTH)가 GCS 없는 환경에서 health failure를
    유발해 arm 명령을 거부하던 문제 수정.
    airframe 파일 기본값 수정 및 run_arms.sh에서 COM_DISARM_LAND 제거.
2026-07-08 fix: setup_sim.sh에서 PX4 params 초기화 추가
    airframe 파일 변경 후 기본값이 적용되도록 저장된 params 파일 삭제.
    param reset_all과 동일 효과.
2026-07-08 fix: COM_RC_IN_MODE=1 설정 — RC 수신기 헬스 체크 비활성화
    RC_CHANNELS_OVERRIDE(MAVLink) 구조에서 실제 RC 수신기가 없으므로
    RC_RECEIVER 헬스 체크가 실패해 arm이 영구 거부되던 문제 수정.
    COM_RC_IN_MODE=1("MAVLink only")로 RC 관련 체크를 건너뜀.
2026-07-08 fix: csrf 도입으로 인한 arm error 수정
    [sitl_bridge_node.py]
2026-07-08 docs: 현재 상태 문서화
2026-07-08 feat: sitl 디버깅용 그래프 출력기 추가
2026-07-08 fix: plotjuggler 안 뜨는 오류 수정
2026-07-08 chore: roi 일단 비활성화
2026-07-08 fix: roi 비활성
2026-07-08 fix: detection 실패 처리 방식 변경
    [arms_control_node.cpp, control_params.yaml, state_machine.cpp]
2026-07-08 fix: crsf와 제어 방향 매칭
    [control_params.yaml]
2026-07-08 feat: absdiff 디버깅
2026-07-08 fix: panel 너무 길어져서 줄임
2026-07-08 fix: 제어기 p 선형 증가 제거, 게인은 실시간 튜닝
    [arms_control_node.cpp, control_params.yaml]
2026-07-08 fix: pure pid
2026-07-08 fix: p 최대 범위 조절
2026-07-08 fix: i 범위 늘리기
2026-07-08 fix: p 최대를 500까지
2026-07-08 fix: graph viewer 설정 변경
2026-07-08 refac: 불필요한 파일 삭제
2026-07-08 refac: 파일명 규칙 통일
2026-07-09 refac: command node 정리
2026-07-10 feat: reset 버튼 추가
2026-07-10 fix: pid 튜닝은 값 입력으로
2026-07-14 젯슨으로 esp32 값 받아서 ros2통신으로 변환 테스트
2026-07-14 feat: model weight pt도 저장
2026-07-14 작업한 내역
2026-07-14 fix: 젯슨 도커 세팅, 가중치 tensorRT 변환
2026-07-15 fix: 초기화 버튼 수정
2026-07-15 fix: onnx 모델 삭제
2026-07-15 fix: 리셋 버튼 수정
2026-07-15 fix: 리셋버튼 오작동 수정
2026-07-21 fix: 카메라 오류 해결
2026-07-21 fix: arms 모델 로딩 오류 수정
2026-07-21 fix: yolo ttl 시간제한 추가
2026-07-21 fix: 카메라 실기체 파이프라인 검증
2026-07-21 feat: add sample viedo
2026-07-21 feat: add new sample
2026-07-21 fix: 예시 영상 기반 테스트 추가, 인식 속도 개선
2026-07-23 feat: crsf 테스트 코드 추가
2026-07-23 fix: crsf 수정
2026-07-24 PID 튜닝 확정 + 풍선 대각선 비행 + 공 발사 패널
    [arms_sitl.sdf]
2026-07-28 풍선 비행 튜닝(고도/속도 통일) + 패널 속도 슬라이더 + 제어 파라미터·모델 조정
    - balloon_referee_diagonal: ALT 26, SPEED 통일, 매끄러운 이동(gz.transport)
    - arms_command_node 패널: 풍선 속도(근접/접근) 슬라이더
    - control_params/arms_control_node/arms_drone 모델: 제어·질량 조정
    [model.sdf]
2026-07-28 조종기 튜닝
2026-07-28 fix: command - control 연동 및 통신 규격 정리
    [arms_command_uart_node.cpp, arms_control_node.cpp, sitl_bridge_node.py]
2026-07-28 fix: 실기체 런치 정보 갱신 및 카메라 정보 갱신
2026-07-30 feat: 카메라 전환에 따른 오버레이 표시 여부 변경, 모드 변경 효과음 추가
2026-07-30 fix: yolo까지 하나의 노드에 통합
2026-07-31 알고리즘 정리본 올렸으니까 꼭 보세요
2026-08-01 서보모터 테스트 + CRSF rxtx 확장
2026-08-01 서보모터 동작 확인 완료 + rxtx 통신 되는거 확인함, 단 픽스호크에서 값을 전송해주지 않아서 바인딩 상태값만 rx로 확인함.
2026-08-07 fix: UI 십자선 상시표시·창 크래시 방지, 오발방지, 패널/실행 스크립트 정리
    - arms_ui: 중앙 십자선을 자동/수동 무관 항상 표시, 오버레이 그리기
    예외로 영상 창이 죽던 문제(NameError) 방어 처리
    - state_machine: 무효 거리(-1/0)로는 FIRE 안 하도록 가드 추가(가짜 명중 방지)
    - 패널: 상단 RESET 제거, ACRO 자세제어 왼쪽 컬럼으로 이동, 수동 스로틀
    기본값 중앙(=Altitude 호버)으로 변경
    - run_arms.sh: 정리 단계에 arms_command/arms_detection 종료 추가
    (유령 패널 중복 발행으로 IDLE↔SEARCH 무한 토글되던 문제 방지)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
    [model.sdf]
2026-08-07 fix: 수동/자동 모드에 따라 화면 표시 다르게
2026-08-07 fix: 배터리 디버깅 출력 추가
    [arms_control_node.cpp]
2026-08-07 fix: 모터 제어 / 버튼 관계 및 잠금 처리 / 효과음 추가
    [arms_control_node.cpp, control_params.yaml]
2026-08-07 fix: 효과음 수정
2026-08-07 fix: 서보 테스트 완료 / ui 및 조작기 로직 수정
    [arms_command_uart_node.cpp, arms_control_node.cpp, control_params.yaml]
2026-08-07 feat: PN 유도 + 3.6m/s 이동표적 명중 검증값 고정
    - control_params: guidance PN(1), track_throttle 0.87, lead 0, pn_nav 50,
    pn_center 15, max_tilt 55 (3.6m/s RTL 성공 검증값)
    - 심판: 실제 충돌 시 풍선이 맞은 방향으로 튕겨 날아감(물리반응), 포획반경 3.5
    - 패널 기본값을 검증값과 일치(유도 PN, track 0.87, PN 50/15)
    - model.sdf: 카메라 60Hz·레이 30Hz/넓은 콘 (LOS 추정 신선도↑)
    - run_arms: ACRO 220°/s·최대기울기 65° 고속표적 부스트
    - PARAMS_REFERENCE.md: 정지공/2.2/3.6m/s 상황별 파라미터 표
    [model.sdf]
2026-08-07 fix: esp32 패킷 폭주로 인한 스위치 효과음 폭주 오류 수정
    [arms_command_uart_node.cpp]
2026-08-10 fix: arms model v2로 업데이트
    [1345_prop_ccw.stl, 1345_prop_cw.stl, arms_model_v2.stl, model.sdf, ver_ksh_assembly.stl]
2026-08-10 refac: 문서 업데이트 및 폴더 구조 정리
2026-08-10 feat: 드론 인식 yolo 모델 추가
2026-08-11 fix: 250급 기체 base에 SITL 코드수정 반영
    - referee: 명중 후 공이 튕겨나간 뒤 사라지지 않고 그 자리 유지, 드론이름 매칭 확장(drone/x500)
    - 추미(Pursuit): 빠른 표적일 땐 중앙 게인 감쇠 해제 → 뒤처짐 방지(정지공 지터방지는 유지)
    - arms_command: 없는 servo 테스트노드 설치 제거(빌드에러 해결)
    - .gitignore: *.leadbak/*.massbak 추가
    [arms_control_node.cpp]
2026-08-11 fix: tunning
    [model.sdf]
2026-08-11 fix: 타겟을 x500으로 전환 가능
    [arms_sitl.sdf, model.sdf]
2026-08-11 fix: pt 모델을 tensorRT로 빌드
2026-08-11 fix: 부팅 시 현재 모드 안내 & 스틱 ilde 모드 확인 로직 추가
    [arms_control_node.cpp, control_params.yaml]
2026-08-11 chore: gitignore 업데이트 및 예전 문서 삭제
2026-08-11 fix: fire 전이 조건을 비전 기반으로 변경 & 거리 기반 판정 모두 제거
    [arms_control_node.cpp, control_params.yaml, state_machine.cpp]
2026-08-11 fix:킬 스위치 경고 문구 변경 및 음성 안내 추가
2026-08-11 feat: 부팅 후 자동 실행 스크립트 준비
2026-08-11 fix: RTL에서 altitude 모드로 전환 및 arm 유지
    [arms_control_node.cpp]
2026-08-11 refac: 자동=ACRO 전환에 맞춰 자세 피드백 제거 & 안 쓰는 토픽/파라미터 정리
    - /arms/attitude 구독·발행 제거(sitl_bridge). acro 출력은 자세 피드백 없이
    비전 유도출력→각속도 직접 명령 (auto=PX4 ACRO, manual=Altitude)
    - /arms/reset_cmd 제거 (발행자 없는 수동 훅)
    - 거리 기반 종말 부스트(pn_commit_*, terminal_active_) 죽은 코드 전면 제거
    - control_debug/debug_looming: 구독자 있을 때만 발행 (헛발행 제거)
    - DESIGN.md 제어 로직 동기화: 7.5 유도·제어 재작성, auto=ACRO 반영,
    kp_ramp 등 없어진 파라미터 정리
    [arms_control_node.cpp, control_params.yaml, sitl_bridge_node.py]
2026-08-11 fix: 실제 질량 반영
    [model.sdf]
2026-08-11 fix: command GUI에서 제거된 자세보정 파라미터 위젯 삭제
    control 노드가 acro(각속도) 제어로 전환되며 자세 피드백 파라미터를
    삭제(att_comp/att_roll_sign/att_pitch_sign)했으나, command GUI가
    여전히 이들을 ros2 param set 으로 참조해 누르면 에러가 났음.
    - att_comp Scale 슬라이더 제거
    - 자세 부호 뒤집기 버튼(asgn 프레임) 제거
    - flip_att_roll/flip_att_pitch 핸들러 제거
2026-08-11 재산표 추가
    [INAIR_재산표.xlsx]
2026-08-12 fix: 기체 추력 변경
    [model.sdf]
2026-08-12 fix: 폴더 정리 & arms_command, arms_sim 분리
2026-08-12 docs: command, sim 문서 및 주석 수정
2026-08-12 fix: control의 config 미매칭 수정 & UI 수정 및 레거시 제거
    [arms_control_node.cpp, control_params.yaml, hw_overrides.yaml]
2026-08-13 fix: UI 정리 & hit 판정은 참고로만 & refac
    [arms_sitl.sdf]
2026-08-13 fix: 패키지 빌드 관련 설정 변경 & 순수 PID 제어기만 남김
    [arms_control_node.cpp, control_params.yaml, hw_overrides.yaml]
2026-08-13 chore: 주석 정리
2026-08-13 fix: yolo 가중치 선택 가능하게
2026-08-13 fix: SITL에서는 실제 충돌로 hit 처리 & 불필요한 터미널 출력 제거
    [arms_command_uart_node.cpp, arms_control_node.cpp, control_params.yaml, state_machine.cpp]
2026-08-13 fix: docker OOM 발생 시 안전하게 복구할 수 있게 수정
2026-08-14 fix: 미사용 메시지 삭제
2026-08-14 docs: 문서 업데이트
2026-08-14 fix: elrs tx를 c타입으로 연결 가능하게 설정
    [hw_overrides.yaml]
2026-08-14 fix: startup 설정 변경
2026-08-14 fix: elrs 연결 & 배터리 표시 & 비프음추가
    [arms_control_node.cpp, control_params.yaml, hw_overrides.yaml]
2026-08-14 feat: SEARCH에서 YOLO/HSV/ABSDIFF 작동여부·confidence UI 표시
    detection이 /arms/detector_status([yolo,hsv,absdiff])를 발행하고 UI가
    SEARCH 상태에서 좌상단에 각 검출기 작동여부와 confidence를 표시한다.
    LOCK 판단은 YOLO 전용(acquire.yolo_only) 유지 — CV는 표시용으로만 실행.
2026-08-14 feat: 배터리 전압 보정 + LOCK/ROI 검출기 상태·모드 UI 표시
    - battery.voltage_offset 파라미터 추가 (실측 대비 보정, hw_overrides +0.6V)
    - detector_status 를 LOCK(ROI) 경로에서도 발행하고 mode(FULL/ROI) 필드 추가
    - UI 가 SEARCH·LOCK·추적 상태에서 3검출기 %와 검출 모드 표시
2026-08-15 feat: ballon_v2 가중치 업로드
2026-08-15 fix: fp16 양자화 고정
2026-08-15 feat: 원거리 획득 HSV후보→YOLO확대검증 (원거리 탐지+헛-LOCK 방지)
2026-08-15 Improve balloon detection with camera-trained model
2026-08-16 feat: 전압 보정 & 전원 버튼 추가 & 추적 알고리즘 변경
2026-08-16 feat: add sample video
2026-08-16 fix: replay 작동할 수 있게 수정
2026-08-16 fix: detection 문서화
2026-08-16 fix: 디버깅 영상 표시 추가 & 문서 업데이트
2026-08-16 fix: 모델 양자화+tensorRT 변환 & 리플레이 수정
2026-08-16 feat: 새로 학습한 yolo11n 모델 추가
2026-08-16 fix: 영상 지연시간 개선
2026-08-16 fix: 영상처리 지연시간 최적화
2026-08-16 fix: ui 텍스트 출력 수정
2026-08-17 docs: plotjuggler 설명 항목 추가
2026-08-17 fix: onnx 중간저장 없앰
2026-08-17 fix: debug UI 구분 & lock 프로그레스바오류 수정
    [arms_control_node.cpp, control_params.yaml]
2026-08-17 fix: 전압 offset 설정
    [hw_overrides.yaml]
2026-08-17 기능: HSV 튜닝 및 화면 캡처 기능 추가
    [pyvenv.cfg]
2026-08-19 fix: 새로운 nano 모델로 교체
2026-08-19 fix: 스피커 소리 안 나는 오류 수정
2026-08-19 fix: 부팅 시 실행되게 설정
2026-08-19 fix: elrs, 모드 화면에 표시 & elrs 관련 소리 추가
    [arms_control_node.cpp]
2026-08-19 chore: 가상환경은 추적에서 제거
    [pyvenv.cfg]
2026-08-19 docs: 문서최신화
2026-08-19 chore: 이미지 캡처 관련 문서화 및 추적 제거
2026-08-20 fix: speedybee에 맞게 텔렘 세팅 변경 & 조종기 텔레메트리 인식 방식 변경
    [arms_control_node.cpp, hw_overrides.yaml]
2026-08-21 fix: hsv 파라미터 튜닝
2026-08-21 fix: lock 절대 안 풀리게 수정
    [arms_control_node.cpp]
2026-08-26 fix: docker 실행되도 토픽 발행 안 되면 재실행되게 수정
2026-08-26 fix:서보 잠금 여부 조절 부분 수정
    [arms_control_node.cpp]
2026-08-26 fix: 기본 게인 수정
    [hw_overrides.yaml]
2026-08-26 fix: detection 실내 config 분리 & 결과 위치 필터 적용 & 미사용 config 제거
    [arms_control_node.cpp, control_params.yaml, state_machine.cpp]
2026-08-26 fix: 실내에서 튜닝 작업
    [control_params.yaml, hw_overrides.yaml]
2026-09-04 fix: 실기체 pid 튜닝
    [hw_overrides.yaml]
2026-09-04 fix: 영상 기반 검증 시 조종기 옵션 조절 가능하게
2026-09-04 fix: 디버깅용 표시 추가
2026-09-04 fix: fallback 기준 변경
2026-09-04 fix: detection 노드 트래커 제거 & KF와 룰 기반 추적기 및 상태 머신 추가
2026-09-04 fix: 미사용 코드 제거 & track 핸드오버 가능하게 & hit 판정 파라미터 분리
    [arms_control_node.cpp, control_params.yaml, hw_overrides.yaml, sitl_bridge_node.py, state_machine.cpp]
2026-09-04 feat: ui topic 발행 추가
2026-09-04 fix: debug 모드가 아니어도 화살표 표시
2026-09-05 feat: ui 화면을 토픽으로 발행
2026-09-05 chore: 모델엔진으로 변환한 것 추가
2026-09-05 feat: crsf topic 발행 추가
2026-09-05 feat: ui ros bag 녹화 기능 추가
2026-09-06 feat: 배터리 셀 수는 알아서 계산하게
2026-09-06 remove: docker watchdog 삭제
2026-09-06 refac: 모델 이름 변경 & 젯슨에 등록할 서비스는 따로 정리 (부팅/스피커)
2026-09-06 fix: roi는 ui가 발행하도록
2026-09-07 feat: 실험 로깅 기능 추가
2026-09-07 feat: 비행/추적 로그 남기기
2026-09-14 chore: 파라미터 수정
2026-09-14 fix: bag 복구 스크립트 수정
2026-09-14 remove: remove sample video
2026-09-15 refac: arms_sim에 px4 설정 넣기
    [1345_prop_ccw.stl, 1345_prop_cw.stl, arms_model_v2.stl, arms_sitl.sdf, model.sdf, ver_ksh_assembly.stl]
2026-09-15 refac: yolo 관련 정리
2026-09-15 fix: yolo 학습 ipynb 수정
2026-09-15 docs: SW readme 업데이트
2026-09-15 feat: reset 기능 추가
    [arms_control_node.cpp]
2026-09-17 feat: sitl은 host에서 yolo 실행 & reset 기능 추가 & rviz 추가
    [sitl_bridge_node.py]
2026-09-23 fix: lead 및 pn 제어 테스트
    [arms_control_node.cpp, control_params.yaml]
2026-09-24 IBVS 공선유도(mode 2) + tau 기반 추력감속 추가
2026-09-30 chore: pt 새로 추가 / 등록 코드 변경
2026-09-30 feat: 카메라 파리미터 추가 & 로깅 추가
2026-09-30 fix: sitl에서도 녹화되게
2026-09-30 fix: 뷰어 업데이트
2026-09-30 fix: 뷰어 수정
2026-10-01 docs: ibvs 문서 오류 수정
2026-10-01 fix: 뷰어에서 각도도 볼 수 있게 수정
2026-10-01 fix: 기본 가중치 변경
2026-10-01 feat: 카메라 캘리 코드 추가
2026-10-01 feat: 풍선 테스트 영상 추가
2026-10-01 fix: 카메라 캘리 기본값 변경
2026-10-01 fix: 기체 스펙 반영
    [model.sdf]
2026-10-01 chroe: 풍선 초깃값 변경
    [arms_sitl.sdf]
2026-10-01 revert: test/new-control(PN 튜닝) 머지 되돌림
    2d1b4b0 머지로 들어온 d711e07(lead 및 pn 제어 테스트) 변경을 되돌린다.
    - control.aim_offset_y 파라미터 제거
    - pn_center_gain 220 → 52.5
    - SITL 패널 유도 방식 기본 표시/조준 오프셋 슬라이더 원복
    This reverts commit 2d1b4b0, reversing changes made to ba44f1a.
    [arms_control_node.cpp, control_params.yaml]
2026-10-01 fix: update control params
    [control_params.yaml]
2026-10-01 fix: ui 녹화도 추가 / 뷰어 수정
2026-10-01 fix: 카메라 스펙 반영하여 sitl 설정 수정
    [model.sdf]
2026-10-02 fix: mode 0 offset 기능 추가
    [arms_control_node.cpp, control_params.yaml]
2026-10-02 fix: off 버튼 숨기기
2026-10-09 feat: kill 대신 rtl & gps 추가 & 상태머신에서 fire 제거
2026-10-09 fix: ui에서 gps 위치 변경 & sitl에서 gps 잡히게
    [sitl_bridge_node.py]
2026-10-09 fix: ui 오류 수정
2026-10-09 fix: sitl rtl 맵핑 수정
    [sitl_bridge_node.py]
2026-10-09 feat: 세부 항목 로깅 추가 & 디버깅 뷰어에 3d 뷰어 추가 및 새 토픽 그래프 추가
2026-10-09 fix: recorder 종료 오류 수정
2026-10-09 fix: 3d 뷰어 업데이트 & 자세 발행 추가
    [arms_control_node.cpp, sitl_bridge_node.py]
2026-10-09 fix: 자세 로깅 오류 및 뷰어 수정
2026-10-09 fix: 축 방향 변경 및 모드에 따른 움직임 제한 반영
2026-10-12 docs: stage I/O refactor rollout
2026-10-12 fix: preserve autonomous rate command limit
    [arms_control_node.cpp]
2026-10-13 fix: apply parameters to namespaced nodes
    [control_params.yaml, hw_overrides.yaml]
2026-10-13 fix: support required parameters on humble
    [arms_control_node.cpp, arms_operator_hardware_node.cpp]
2026-10-13 fix: declare required parameter types
    [arms_control_node.cpp, arms_operator_hardware_node.cpp, crsf_io_node.py, sitl_bridge_node.py]
2026-10-13 fix: require typed Python parameters
    [crsf_io_node.py, sitl_bridge_node.py]
2026-10-13 refactor: move camera and perception topics into domains
2026-10-13 feat(sim): add shoulder launcher SITL
    [arms_sitl.sdf]
2026-10-13 feat(sitl): force disarm PX4 on arm switch off
2026-10-13 fix(control): check target loss from control loop
    [arms_control_node.cpp, control_params.yaml, state_machine.cpp]
2026-10-13 Revert "feat(sim): add shoulder launcher SITL"
    This reverts commit f20d7bb7fcf3e356586f6112b84d3631d5864cb1.
    [arms_sitl.sdf]
2026-10-13 fix(control): use camera tan coordinates for guidance
    [model.sdf]
2026-10-13 fix(sim): restore camera pose physics
    [model.sdf]
2026-10-13 refactor(sim): base ARMS SITL on generic 250 racer
    [model.sdf]
2026-10-14 fix(control): preserve arm for auto-to-manual handover
    [arms_control_node.cpp]
2026-10-14 Reapply "feat(sim): add shoulder launcher SITL"
    This reverts commit 348cfb6c2fc372389514fa9bdde318122efc8660.
    [arms_sitl.sdf]
2026-10-14 refactor(sim): make launcher pose-driven
    [arms_sitl.sdf]
2026-10-14 feat(sim): move launcher payload with kinematic tube
    [arms_sitl.sdf]
2026-10-14 tune(sitl): shorten heartbeat timeout
    [sitl_bridge_node.py]
2026-10-15 fix(scripts): pin opencv-python<5, numpy<2 for cv_bridge compat
    핀이 없으면 pip 가 OpenCV 5 를 끌어와 ~/.local 에서 시스템
    python3-opencv(4.5.4)를 가린다. OpenCV 5 는 타입 상수값이 바뀌어
    (CV_8UC3 16→64) 4.5.4 로 빌드된 cv_bridge C++ 바이너리와 어긋나고,
    cv2_to_imgmsg 가 KeyError: 16 으로 죽는다. 수신(imgmsg_to_cv2)은
    멀쩡하므로 '화면은 나오는데 /arms/ui/image 발행만 실패'하는
    형태로 드러난다 — rosbag 녹화가 안 되던 원인.
    numpy<2 는 apt python3-opencv 4.5.4 가 NumPy 1.x 로 빌드된 것과 맞춘다.
2026-10-15 fix(detection): apply ROS namespace via __ns remap in docker compose
    ROS_NAMESPACE is a ROS 1 environment variable and rclpy does not read it,
    so the containerized detection node came up in the root namespace as
    /arms_detection_node. That broke two things at once:
    - config/detection.yaml is keyed under `/arms/arms_detection_node:`, which
    never matched the node's FQN, so every required parameter was missing and
    require_parameter() refused to start the node
    (ParameterUninitializedException: 'proc_width' is not initialized).
    - the node's relative topic names (camera/image_raw, perception/detections)
    bound to the root namespace instead of /arms.
    Pass `-r __ns:=/$ROS_NAMESPACE` explicit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
2026-10-15 fix(io): set CRSF baud to 115200 for CP2102 USB module
    The baud stayed at 400000 from the 40-pin UART (/dev/ttyTHS1) days
    while the port default moved to the CP2102 USB-C module
    (/dev/ttyUSB0), so no valid CRSF frame ever arrived and io/status
    reported "CRSF telemetry timeout" with last_rx_age_ms never set.
    Verified on hardware with scripts/crsf/crsf_cport.py at 115200:
    640 valid frames in 15 s, LQ 100%, RSSI -33 dBm, 0x14/0x1E/0x3A
    received.
2026-10-15 feat(io): measure CRSF UART transport rates
2026-10-16 fix(control): hand over to manual on track target loss
    [arms_control_node.cpp, control_params.yaml, state_machine.cpp]
2026-10-16 fix(ui): report vehicle telemetry link state
    [arms_control_node.cpp]
2026-10-19 Add drone and launcher STEP files
    [body.step, body_1.step, body_2.step, body_3.step, body_display_mount.step, body_lid.step, control_panel.step, display_bracket.step]
